TonnyChenProgramming/701/701_documentation/RecopDiagrams/taskSeperation.png

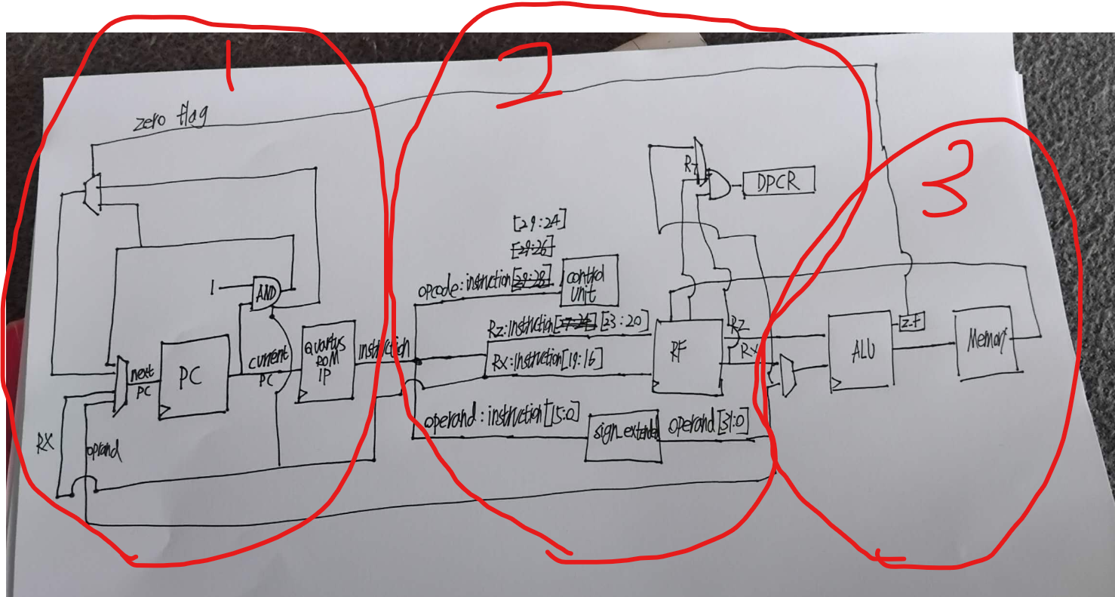
701_documentation/RecopDiagrams/taskSeperation.png
