TonnyChenProgramming/701/701_documentation/GP2_Member_B_Nios_Support_Plan.md

# GP2 Member B Nios II Support Plan

Owner: Eric / Member B

Branch: `Eric_GP2`

## Purpose

Member B owns the non-critical Nios II support path for GP2. After Zoran's MVP feedback, the minimum target is not to upload ReCOP instruction memory and not to force all Nios commands through ReCOP. The minimum target is to let a PC user send UART/JTAG UART configuration commands to Nios II, let Nios II package those commands as NoC packets for the relevant ASPs, and let Nios II display returned peak/frequency results from the NoC.

## Agreed System Flow

```text
PC UART command
    -> Nios II command parser
    -> Avalon-MM / NoC adapter registers
    -> ASP configuration packet over NoC
    -> ASP pipeline updates parameters
    -> Peak/result packet returns over NoC
    -> UART debug output and VGA result display
```

ReCOP remains useful, but its MVP role is the board-driven reactive controller: switches/buttons trigger START/STOP/CLEAR/status control packets to ASPs and LEDs show the result. Nios II is the UART/config/display processor.

Status is split by command owner. Nios II receives `CONFIG_DONE` and PK result/event packets because it owns UART configuration and display. ReCOP receives `START_DONE`, `STOP_DONE`, and `CLEAR_DONE` because it owns switches/buttons and the four ASP LEDs.

## Responsibility Split

| Member | Area | Main Responsibility |
| --- | --- | --- |
| A | ReCOP + board input controller | Read switches/buttons, send START/STOP/CLEAR/status packets to ASPs, drive LEDs/status response. |
| B | Nios II support subsystem | UART command parser, Nios-to-NoC register contract, ASP configuration packets, PK/result display path. |
| C | TDMA-MIN + ASP pipeline | NoC routing, ASP address map, ADC/AVG/COR/PK/output data movement, waveform evidence. |

Member B does not need to implement ASP algorithms or ReCOP internal instruction behavior. Member B only needs a clean support interface that can drive known ASP configuration packets and display returned status/results.

## GP2 Operating Modes

| Mode | Name | Intended Data Path |
| --- | --- | --- |
| `mode 1` | Correlation pipeline | `ADC -> AVG -> COR -> PK -> NoC -> Nios display` |
| `mode 2` | Direct pass-through | `ADC/source -> NoC/output`, bypassing `AVG/COR/PK` where possible |

The exact NoC route for mode 2 should be confirmed by Member C because it depends on how the TDMA-MIN ports are connected.

## Minimum Member B Deliverables

1. Nios II UART/JTAG UART command parser.
2. Packet helper definitions matching `common/asp_packet_pkg.vhd`.
3. Avalon-MM register contract for the Nios-to-NoC adapter.
4. Dry-run command output showing the 32-bit packet words Nios would send.
5. Evidence checklist for hardware/simulation testing.

The current implementation can run in dry-run mode before the hardware adapter is finished. When Platform Designer provides the adapter base address, the same console can be built with `NIOS_NOC_ADAPTER_BASE` so the command helpers write the adapter registers.

## UART Command Set

| Command | Meaning | Initial Nios Action |
| --- | --- | --- |
| `adc <dest> <ch> <div>` | Set ADC output destination, virtual channel, and sample divider. | Build and send/print ADC config packet. |
| `avg <dest> <win>` | Set AVG output destination and window `1,2,4,8,16`. | Build and send/print AVG config packet. |
| `corwin <n>` | Set correlation window `1..511`. | Build and send/print COR window config packet. |
| `offset <n>` | Set correlation offset | Build and send/print a COR config packet with offset value `n`. |
| `pk <dest> <sp> <th>` | Set PK output destination, min spacing, and threshold. | Build and send/print PK config packet. |
| `poll` | Read one returned packet from the hardware adapter | If `RX_VALID` is set, print decoded packet fields and acknowledge RX. |
| `rx <hex>` | Mock/decode one received packet | Dry-run display hook for PK/result packets before hardware RX exists. |
| `status` | Show current system status | Print cached ASP config, adapter status, and latest received packet/result. |

## Status / LED Rule

For MVP, status should not be broadcast everywhere. The target is:

```text
Nios CONFIG command -> ASP -> CONFIG_DONE status to Nios
ReCOP START command -> ASP -> START_DONE status to ReCOP -> LED on
ReCOP STOP command  -> ASP -> STOP_DONE status to ReCOP -> LED off
ReCOP CLEAR command -> ASP -> CLEAR_DONE status to ReCOP -> LED off
PK peak result      -> PK ASP -> EVENT packet to Nios
```

Nios caches the latest peak count, successful ASP config acknowledgements, and the most recent status response. UART can print this snapshot immediately. A later VGA layer should read the same snapshot instead of containing packet-decoding logic.

The lightweight `nios_display` module now formats this snapshot for UART and an optional Avalon character-buffer VGA. It deliberately avoids the larger C723 FreeRTOS graph task until the basic NoC result path works.

Suggested LED mapping:

| LED | ASP |
| --- | --- |
| `LED0` | ADC |
| `LED1` | AVG |
| `LED2` | COR |
| `LED3` | PK |

## Packet Format

The shared packet format is defined in `common/asp_packet_pkg.vhd`:

```text
[31:28] kind
[27:24] code
[23:20] dest
[19:0]  payload
```

Current shared node map:

| Node | Address |
| --- | --- |
| ReCOP/control source | `0x0` |
| ADC ASP | `0x1` |
| AVG ASP | `0x2` |
| Correlation ASP | `0x3` |
| Peak ASP | `0x4` |
| Nios II bridge | `0x5` |
| Idle/debug sink | `0x6` |
| Null/drop sink | `0x7` |

For Nios configuration commands, `dest` should be the target ASP address. ReCOP address `0x0` is mainly for ReCOP-originated board-control/status behavior, not the default Nios MVP path.

## Proposed Nios-to-ASP Command Packets

These packet words follow the shared packet layout and the current ASP decoder payload formats.

| UART Command | Packet Meaning | Example Word |
| --- | --- | --- |
| `adc avg 0 0` | `CMD_CONFIG` to ADC, output to AVG, channel `0`, divider `0` | `0x11120000` |
| `avg cor 4` | `CMD_CONFIG` to AVG, output to COR, window `4` | `0x11230200` |
| `corwin 64` | `CMD_CONFIG` to COR, `TAG_WINDOW`, value `64` | `0x11300040` |
| `offset 100` | `CMD_CONFIG` to COR, `TAG_OFFSET`, value `100` | `0x11310064` |
| `pk nios 200 0` | `CMD_CONFIG` to PK, output to Nios, spacing `200`, threshold `0` | `0x1145C800` |

Current tagged config fields:

| Tag | Meaning |
| --- | --- |
| `0x0` | Existing `TAG_WINDOW`, used by COR. |
| `0x1` | Existing `TAG_OFFSET`, used by COR. |

ADC, AVG, and PK currently use compact payload bitfields instead of tag/value payloads. See `ASP_NoC_Command_Interface.md` for the detailed layouts.

## Instruction Memory Upload Note

Instruction-memory upload is optional/stretch for GP2. The current ReCOP program memory is ROM/MIF based, so run-time upload would require a larger hardware change: writable program memory, an Avalon loader interface, reset/start control, and evidence that ReCOP fetches uploaded instructions.

For the minimum GP2 path, Nios II should not block on instruction-memory upload. The practical Member B path is:

```text
Nios II UART command -> NoC adapter -> ASP configuration packet
```

Instruction-memory upload can be revisited only if the team finishes the UART/config/status path early.

## Teammate Update Message

```text
I am working on Member B on branch Eric_GP2. After Zoran's MVP feedback, Nios II is mainly for UART configuration and UART/VGA display. It should not need ReCOP instruction-memory upload, and PK should not connect directly to Nios. My MVP flow is PC UART command -> Nios II -> NoC config packet -> target ASP, and PK/result packet -> NoC -> Nios II -> UART/VGA display. ReCOP stays useful as the board-driven reactive controller for START/STOP/CLEAR/status using switches/buttons/LEDs.
```

## Open Team Decisions

1. Confirm ADC/AVG TDMA wrappers from `origin/solomon-tdma-only` are merged into the team baseline.
2. Confirm whether ReCOP switch mode control changes ADC/AVG/COR routing or only START/STOP/CLEAR state.
3. Connect the exported adapter `noc_send` and `noc_recv` conduits to TDMA-MIN in Member C's integration top level. The Platform Designer adapter is mapped at `0x08011000`.
4. Confirm PK/result packet format for Nios display.

## Current Member B Progress

Completed:

1. Nios UART/JTAG UART command parser and compact console output.
2. Shared packet helpers and Avalon-NoC adapter register contract.
3. ModelSim adapter testbench with TX/RX handshake and loopback coverage.
4. Platform Designer adapter integration at `0x08011000`.
5. Physical-board adapter-local loopback smoke test.
6. Optional text-only VGA character-buffer build path at `0x08012000`.
7. Quartus full compilation and FPGA programming with the VGA build path.

Remaining:

1. Member C connects `noc_send` and `noc_recv` to the TDMA-MIN top level.
2. Run the real NoC test with `hwloop 0`.
3. Capture a VGA monitor photo later when a cable is available.
