TonnyChenProgramming/701/701_documentation/GP1_ReCOP_Design_Report.docx

COMPSYS 701 – Group Project 1
ReCOP Processor Implementation
Design Report

Group 6
Eric Chen (eche101) Tonny Chen (tche867) Xueyuan Ye (xye006)

# 1. Introduction

This report documents the design and implementation of a fully operational ReCOP (Reactive and Concurrency Processor) core completed for Group Project 1. ReCOP is a 16-bit RISC processor originally specified as a high-level programming model in the COMPSYS 701 materials. Our task was to expand that specification into a complete, synthesisable RTL design, build a supporting assembler toolchain, and demonstrate the processor executing user programs on an Intel/Altera FPGA.

The deliverables described in this report are: (i) a multi-cycle ReCOP datapath and control unit written in VHDL, (ii) a two-pass Python assembler that emits an Altera Memory Initialisation File (.mif) for the Program Memory, (iii) a QuestaSim testbench and regression program exercising all implemented instructions, and (iv) a synthesised design targeting the Terasic DE1-SoC development board, which hosts an Intel Cyclone V FPGA. The remainder of the report explains the system architecture, describes each major block, lists the customisations we made relative to the reference specification, and outlines how the design will extend into GP2.

# 2. System Architecture

## 2.1. ReCOP ISA

ReCOP follows a Harvard architecture with a separate Program Memory (PM) and Data Memory (DM). Each instruction is 32 bits wide and has the following fixed format:

[AM:2] [Opcode:6] [Rz:4] [Rx:4] [Operand:16]

## 2.2. ReCOP Datapath

The datapath is organised into five logical blocks to meet the ISA requirement.

- Block 1 – Fetch: Program Counter and Instruction Memory Quartus ROM IP
- Block 2 – Decode and Control: Register file and control unit
- Block 3 – Execute: Arithmetic logic unit and External Register port in
- Block 4 – Memory: Data Memory Quartus RAM IP
- Block 5 – WriteBack: the same register file

In the fetch stage, the next program counter (PC) value is generated by the program counter module and provided to the instruction memory (ROM IP) to retrieve the next instruction. Both the PC update and the instruction memory access require one clock cycle.

During the decode stage, the instruction is interpreted by the control unit, which generates the necessary control signals for the subsequent stages. At the same time, the register file is accessed to read the required operand values based on the instruction fields.

In the following stage, the data path is directed according to the control signals. If an arithmetic or external port interaction is required, the operands are sent to the execute block. Alternatively, for memory-related instructions, the operation is handled by the memory block to perform data read or write.

Finally, in the write-back stage, the result is written back to the register file when required by the instruction.

## 2.3. ReCOP Control Path: A Moore's Machine Implementation

The Control Unit is a Moore-style finite state machine with six top-level states – Fetch (S_FETCH), Decode (S_DECODE), Execute (S_EXECUTE), Memory Read (S_MEMREAD), Memory Write (S_MEMWRITE), and Writeback (S_WRITEBACK) – that loop indefinitely.

Each state has a duration equal to one system clock period of 20 ns (50 MHz), as determined through timing analysis in Quartus.

During clock cycle 1, S_FETCH retrieves the instruction from program memory based on the current PC value. In clock cycle 2, S_DECODE interprets the instruction using combinational logic to determine the next state and reads the required operands from the register file. In clock cycle 3, the system transitions to S_EXECUTE, S_MEMREAD, or S_MEMWRITE depending on the decoded instruction. In clock cycle 4, the system either returns to S_FETCH or enters S_WRITEBACK to write the computed result back to the register file.

## 2.4. System-Level Context

The ReCOP delivered by GP1 will be integrated into a Heterogeneous Multi-Processor System-on-Chip (HMPSoC) during GP2. The critical subsystem comprises three Application-Specific Processors (ADC-ASP, Processing-ASP, and DAC-ASP) interconnected by the TDMA-MIN Network-on-Chip. ReCOP acts as the reactive controller: it receives user commands from on-board peripherals and issues configuration commands over the NoC to the ASP pipeline. A Nios II processor joins the same NoC to provide debugging and reconfiguration services.

## 2.5. ReCOP Top-Level Interface

The top-level entity exposes the following external interface to DE1-SoC peripherals:

Signal | Direction | Width | Purpose
CLOCK_50 | in | 1 | System clock (50 MHz)
KEY[3:0] | in | 4 | Reset and soft buttons (active-low)
SW[17:0] | in | 16 | Configuration inputs / SIP source (lower 16 bits)
LEDR[17:0] | out | 16 | Status output / SOP display (lower 16 bits)
HEX0..HEX7 | out | 7 each | Seven-segment digits (SVOP and PC for debug)
DPCR_out | out | 32 | Data-processing call register to NoC (GP2)

## 2.6. Memory Organisation

Program Memory is implemented as a 512 × 32-bit ROM using an Altera altsyncram megafunction in single-port ROM mode, initialised with program.mif. Data Memory is a 512 × 32-bit synchronous RAM from the same megafunction in SINGLE_PORT mode. Both memories target the Cyclone IV E device family and occupy two M9K block-RAM resources each.

The DM is 32 bits wide rather than 16 bits to keep PM and DM architecturally uniform and to leave headroom for GP2, where 32-bit data structures such as DPCR snapshots can be stored without a second memory pass. For the 16-bit LDR and STR accesses in GP1, the upper 16 bits of the DM word are zero-extended on writes and discarded on reads.

Both memories use 9-bit addresses, so the PC uses only its lower 9 bits. This keeps BRAM usage compact for GP1 while preserving the full 16-bit address space for GP2.

# 3. Block-Level Design

## 3.1. S_FETCH (T1)

The Fetch block contains a 16-bit Program Counter and the 32-bit Instruction Register. Pre-fetching is used: the PC value is updated in the previous clock cycle (in parallel with T3), so the Fetch stage only consumes one cycle for the instruction memory read.

## 3.2. S_DECODE (T2)

Decode extracts the following fields from IR at T2:

AM = IR[31:30] opcode = IR[29:24] sel_z = IR[23:20] sel_x = IR[19:16] operand = IR[15:0]

Based on the decoded opcode, the control unit determines the next execution path and generates control signals for S_EXECUTE, S_MEMREAD, or S_MEMWRITE. The register file is accessed concurrently so that operand values are available for the next stage.

## 3.3. S_EXECUTE (T3)

The ALU performs the required computation based on the decoded opcode and operands from the register file or the immediate field. S_EXECUTE also handles external port I/O (SIP read, SOP write), special register access (DPCR write, DPRR read), and control-flow resolution (PC ← target for jumps, or PC ← PC + 1 otherwise).

## 3.4. S_MEMREAD (T3)

Data memory is configured in read mode. The retrieved data is forwarded to the register file for the subsequent S_WRITEBACK stage. The PC is updated to PC + 1 in parallel.

## 3.5. S_MEMWRITE (T3)

Data memory is configured in write mode. The data from the selected source (Rx, operand, or PC) is written to the effective address. The PC is updated to PC + 1 in parallel.

## 3.6. S_WRITEBACK (T4)

Entered only for instructions that require a register write-back. The register file write-enable is asserted and the appropriate data source is selected and written to the target register, completing the instruction execution cycle.

## 3.7. Control-Unit State Summary

State | Active Signals | Datapath Action
T1 (S_FETCH) | pc_write=1; pc_sel=pc_sel_zero (init only) | IR ← PM[PC]; PC prepared from previous cycle (prefetch)
T2 (S_DECODE) | rf_read (implicit) | Decode IR; read Rx, Rz; operand prepared for next stage
T3 (S_EXECUTE) | alu_operation, alu_op1_sel, alu_op2_sel, pc_write, pc_sel, dpcr_wr, sop_wr | Rz ← ALU(…); port I/O; DPCR/DPRR; PC ← target or PC+1
T3 (S_MEMREAD) | dm_read_enable, dm_addr_sel, pc_write, pc_sel=PC+1 | data ← DM[address]; forwarded to writeback stage
T3 (S_MEMWRITE) | dm_write_enable, dm_addr_sel, dm_data_sel, pc_write, pc_sel=PC+1 | DM[address] ← data (from Rx, operand, or PC)
T4 (S_WRITEBACK) | ld_r, rf_input_sel | Rz ← ALU result / DM data / immediate / SIP

# 4. Assembler

recop_asm.py is a two-pass Python assembler that translates ReCOP assembly source files (.asm) into Altera Memory Initialisation Files (.mif) for loading into the Program Memory ROM at synthesis time. It also produces a human-readable listing file (.lst) for verification. The assembler is implemented in approximately 570 lines of Python with no external dependencies beyond the standard library.

## 4.1. Instruction Encoding

Every ReCOP instruction is a fixed-width 32-bit word. The field layout matches opcodes.vhd and control_signal_generator.vhd in the hardware:

31 30 29 24 23 20 19 16 15 0
┌─────────┬──────────┬─────────┬─────────┬────────────────┐
│ AM │ OPCODE │ Rz │ Rx │ OPERAND │
│ 2 bits │ 6 bits │ 4 bits │ 4 bits │ 16 bits │
└─────────┴──────────┴─────────┴─────────┴────────────────┘

Field | Bits | Description
AM | 31–30 | Addressing mode
OP | 29–24 | 6-bit opcode
Rz | 23–20 | Destination or primary source register (R0–R15)
Rx | 19–16 | Secondary source register (R0–R15)
OPERAND | 15–0 | 16-bit immediate value or direct memory address

Note: This is the v2 encoding where AM occupies the two most-significant bits. The earlier v1 encoding placed AM in the low bits of the upper byte. The v2 layout lets the control unit extract AM without masking the opcode field, and it is the encoding agreed across all team members' hardware.

## 4.2. Addressing Modes

AM Code | Name | Syntax Prefix | Meaning
00 | Inherent | (none) | No explicit operand — uses implicit values or flags
01 | Immediate | # | OPERAND field holds a literal 16-bit value
10 | Direct | $ | OPERAND field holds a 16-bit memory address
11 | Register | Rn | Operand comes from register Rx; OPERAND unused

## 4.3. Full Opcode Table

Mnemonic | OP (binary) | Default AM | Syntax | Operation
LDR | 000000 | IMM/DIR/REG | LDR Rz #imm / LDR Rz $addr / LDR Rz Rx | Rz ← imm / DM[addr] / Rx
STR | 000010 | DIR/REG/IMM | STR Rx $addr / STR Rz Rx / STR Rz #imm | DM[addr]←Rx / Rz←Rx / Rz←imm
SUBV | 000011 | IMM/REG | SUBV Rz Rx #imm / SUBV Rz Rx | Rz ← Rx − imm / Rz − Rx
SUB | 000100 | IMM | SUB Rz #imm | Rz ← Rz − imm; sets Z flag
AND | 001000 | IMM/REG | AND Rz Rx #imm / AND Rz Rx | Rz ← Rx AND imm / Rz AND Rx
OR | 001100 | IMM/REG | OR Rz Rx #imm / OR Rz Rx | Rz ← Rx OR imm / Rz OR Rx
CLFZ | 010000 | INH | CLFZ | Clear Z flag
SZ | 010100 | IMM | SZ label | Branch to label if Z = 1
JMP | 011000 | IMM/REG | JMP label / JMP Rx | PC ← label / PC ← Rx
PRESENT | 011100 | IMM | PRESENT Rz label | Branch; Rz ← return address
STRPC | 011101 | DIR | STRPC $addr | DM[addr] ← PC
MAX | 011110 | IMM | MAX Rz #imm | Rz ← max(Rz, imm)
ADD | 111000 | IMM/REG | ADD Rz Rx #imm / ADD Rz Rx | Rz ← Rx + imm / Rz + Rx
DATACALL | 101000 | REG | DATACALL Rx | DPCR ← {R7, Rx}; assert IRQ
DATACALL | 101001 | IMM | DATACALL Rx #val | DPCR ← {Rx, val}; assert IRQ
SRES | 101010 | REG | SRES Rz | Rz ← DPRR result register
NOOP | 110100 | INH | NOOP | No operation
LER | 110110 | DIR | LER Rz | Rz ← ER (End-Ready register)
LSIP | 110111 | DIR | LSIP Rz | Rz ← SIP (Serial Input Port)
SSOP | 111010 | DIR | SSOP Rx | SOP ← Rx
SSVOP | 111011 | DIR | SSVOP Rx | SVOP ← Rx
CER | 111100 | INH | CER | Clear ER flag
CEOT | 111110 | INH | CEOT | Clear EOT flag
SEOT | 111111 | INH | SEOT | Set EOT flag

Note: R0 is hardwired to zero in the register file — writes to R0 are discarded.

## 4.4. Source File Syntax

Each source line follows the pattern:

[label[:]] MNEMONIC [operands] [; comment]

Token | Format | Examples
Register | R0–R15 (case-insensitive) | R0, r15, R7
Immediate | #<value> | #10, #0xFF, #0b1010, #0o17
Direct address | $<value> | $0, $0x1FF
Label reference | bare name or #name | LOOP, #LOOP

Directives:

Directive | Syntax | Effect
.ORG | .ORG <addr> | Set the current program counter to addr
.EQU | .EQU <NAME> <value> | Define a named constant (substituted at pass 2)
.WORD | .WORD <value> | Insert a raw 32-bit word at the current PC
ENDPROG / END | — | Stop assembling; remaining lines are ignored

## 4.5. Two-Pass Operation

### Pass 1 — Symbol Collection

The assembler scans every source line, tracking the program counter. Any token that is not a recognised mnemonic or directive is treated as a label and stored in the symbol table with its current PC value. .ORG updates the PC; .EQU populates the equates table; .WORD and instruction lines each advance the PC by one. No code is emitted in pass 1.

### Pass 2 — Code Generation

Each instruction line is encoded into a 32-bit word using the pack() function. Label references and .EQU names are resolved against the tables built in pass 1. Numeric literals accept decimal, 0x hex, 0b binary, and 0o octal. Because all symbol addresses are known before pass 2 begins, forward references are resolved correctly.

The pack() function assembles fields as follows:

word = (am & 0x03) << 30
| (op & 0x3F) << 24
| (rz & 0x0F) << 20
| (rx & 0x0F) << 16
| (operand & 0xFFFF)

## 4.6. Output Files

### MIF File

The Altera Memory Initialisation File is loaded into the altsyncram ROM at synthesis. It declares DEPTH = 512, WIDTH = 32, ADDRESS_RADIX = HEX, and DATA_RADIX = HEX. Every address from 0x000 to 0x1FF is written explicitly; locations containing no instruction are filled with 0x34000000 (the NOOP encoding).

### Listing File

The listing file decodes every assembled instruction into human-readable columns showing the address, 32-bit hex word, addressing mode, opcode mnemonic, Rz, Rx, operand value, and the original source line. It also prints the symbol table and any .EQU equates at the top, making it straightforward to verify program behaviour against expected register and memory state.

ADDR HEX AM OPCODE Rz Rx OPERAND SOURCE
0x0000 47800005 IMM ADD R7 R0 5 ADD R7 R0 #5
0x0001 8C070000 DIR LDR R0 R0 0 LSIP R0

## 4.7. Command-Line Usage

python recop_asm.py source.asm # outputs source.mif and source.lst
python recop_asm.py source.asm -o prog.mif # custom MIF path
python recop_asm.py source.asm -l prog.lst # custom listing path
python recop_asm.py source.asm --depth 256 # non-default PM depth

Copy the output .mif into the Quartus project directory (renaming it to match the filename referenced in instruction_memory_ip.vhd) before running synthesis.

## 4.8. Test Programs

File | Description
example2.asm | Exercises all 24 implemented instructions at least once
alu_basic_test.asm | Focused ALU test: ADD, SUB, SUBV, AND, OR, MAX
full_test.asm | Comprehensive regression: arithmetic, branches, memory, I/O
exmaple_full_test.asm | Extended system-level test including DATACALL and SIP/SOP
test_program.asm | General-purpose test program
pm_test.mif | Pre-assembled MIF for example2.asm — use directly without re-assembling
*.lst | Assembler listing files for each .asm — inspect expected register/memory state

# 5. Additions and Customisations

The baseline ReCOP specification describes a programming model and ISA but leaves many implementation choices open. This section enumerates the concrete design decisions and additions our implementation makes relative to the original specification.

## 5.1. Instruction Format – [AM:2][OP:6] Ordering

The 32-bit instruction places the addressing mode in bits 31–30 and the opcode in bits 29–24. Placing AM at the top of the word makes it straightforward to route AM directly to the Control Unit's output-function MUX without first masking the opcode field. Both the assembler encoder and the hardware decoder agree on this layout, which is important because several instructions (AND, OR, ADD, LDR, STR, DATACALL) share an opcode and are disambiguated only by AM.

## 5.2. Split DATACALL Opcodes

The reference ISA documents a single DATACALL mnemonic with two behaviours: the register form (DPCR ← {R7, Rx}) and the immediate form (DPCR ← {Rx, Operand}). To keep the Control Unit's DPCR-source MUX selection trivially decodable from a single opcode bit, two distinct 6-bit opcodes were allocated: 101000 for the register form and 101001 for the immediate form. The assembler emits the correct opcode automatically based on the number and type of arguments supplied, so this split is invisible to the programmer.

## 5.3. I/O Register Customisation

SIP, SOP, and SVOP are mapped to DE1-SoC on-board peripherals: SIP is driven from SW[15:0]; SOP is routed to LEDR[15:0]; SVOP drives HEX0–HEX3 through a hex-to-segment decoder. HEX4–HEX7 display the lower byte of the PC and the current CU state to support live debugging of program flow.

## 5.4. Reset Behaviour

Reset is active-high internally but driven externally by KEY[0], which is active-low on DE1-SoC; an inverter at the top level reconciles the polarities. On reset the PC is cleared, all general-purpose registers are cleared, the Z flag is cleared, and the DPCR is set to zero. IR is not reset explicitly because T1 overwrites it unconditionally before it is ever consumed.

# 6. Simulation and Testing

Verification is performed in QuestaSim using a VHDL testbench that instantiates the top-level ReCOP and preloads PM with a regression program (example2.asm / pm_test.mif) that exercises every implemented instruction at least once. The testbench drives CLOCK_50 at 20 ns and holds reset high for two cycles, then releases it and runs for several hundred nanoseconds.

Correctness is checked both visually (waveform inspection of the Register File, ALU result, DM bus, and DPCR) and by the written .lst listing from the assembler, which documents the expected behaviour for each instruction. Post-route timing was checked in Quartus; the multi-cycle organisation means the critical path (ALU + register-file write-back) runs comfortably within the 50 MHz clock period with slack to spare.

# 7. Extensions Planned for GP2

From a system-level RTL perspective, the DPRR register will be extended from two bits to three bits, with each bit corresponding to an individual ASP unit, enabling scalable interaction with multiple ASPs. Network interface modules will be implemented at both the transmit (NI TX) and receive (NI RX) ends to support communication over the TDMA-MIN multistage interconnect network.

From a system integration perspective, a programming interface will be introduced between the ReCOP program memory and the Nios II softcore processor, allowing runtime updates of program contents via .mif files without requiring resynthesis.

To support better software implementation, two additional status bits – End of Task (EOT) and EReady (ER) – are introduced. These signals provide a lightweight synchronisation mechanism between the ReCOP core and the ASPs. When ReCOP issues a command to a target ASP, it clears the corresponding DPRR bit to 0, then monitors it until the ASP sets it to 1 to signal completion. ReCOP does not stall during this period, enabling concurrent task execution. Similarly, the EOT and ER bits allow the system to handle asynchronous events reactively, which is reflected in ReCOP's name: Reactive and Concurrent Processor.

# 8. Conclusion

The ReCOP core delivered for GP1 constitutes a complete multi-cycle 16-bit processor implementation, accompanied by a custom assembler and verification flow. All mandatory instructions in the reference ISA are fully supported. The architecture adopts a modular six-block partitioning consistent with the Fetch, Decode, Execute, Memory, and Writeback stages, while meeting the specified clock cycle requirements. Furthermore, the design provides a well-defined external interface, enabling seamless integration into the HMPSoC environment in GP2. The proposed GP2 extensions further strengthen its suitability for system-level deployment.
