TonnyChenProgramming/701/701_documentation/RecopDiagrams/RecopDocs.docx

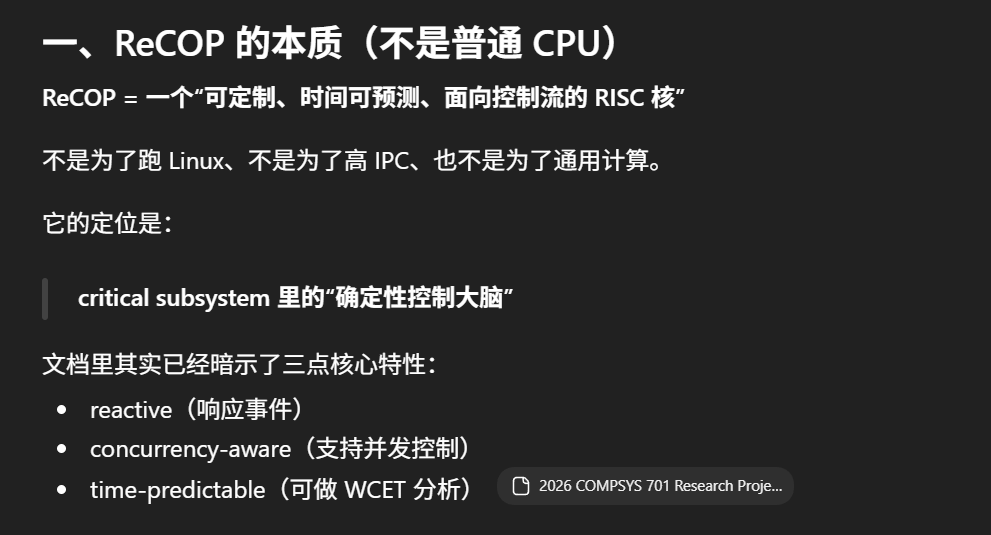
[picture p24: figure]
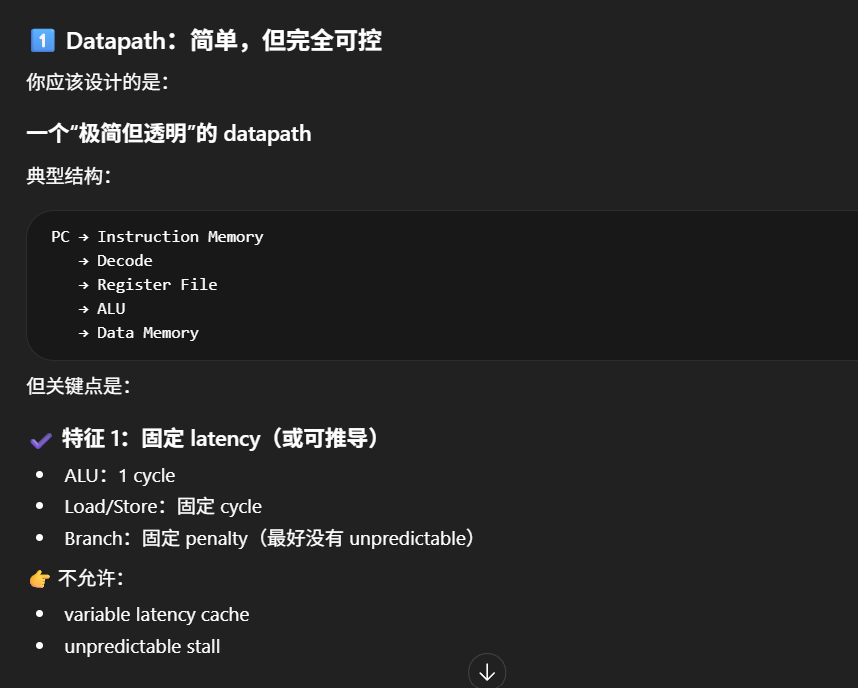
[picture p25: figure]
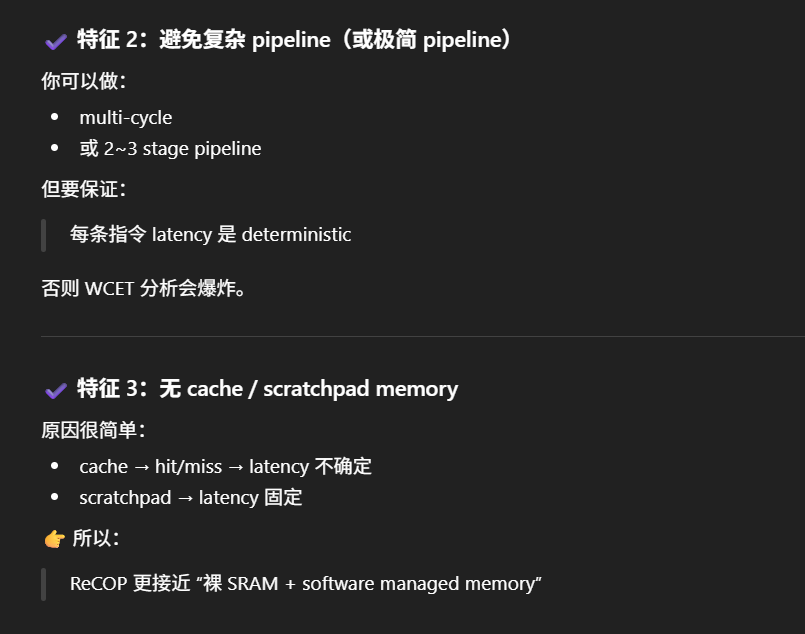
[picture p26: figure]
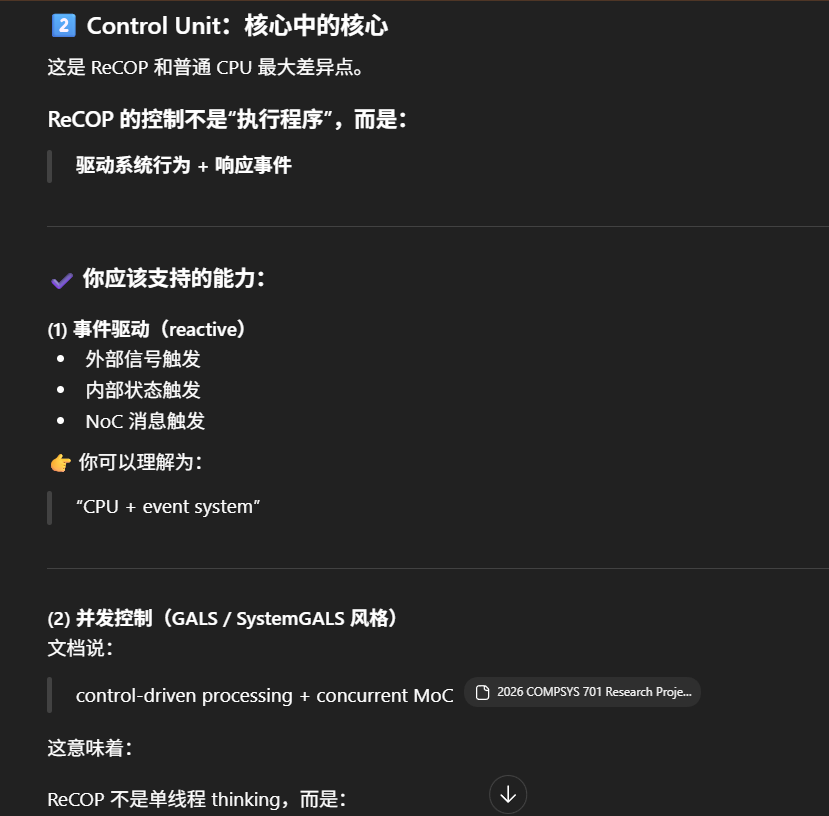
[picture p27: figure]
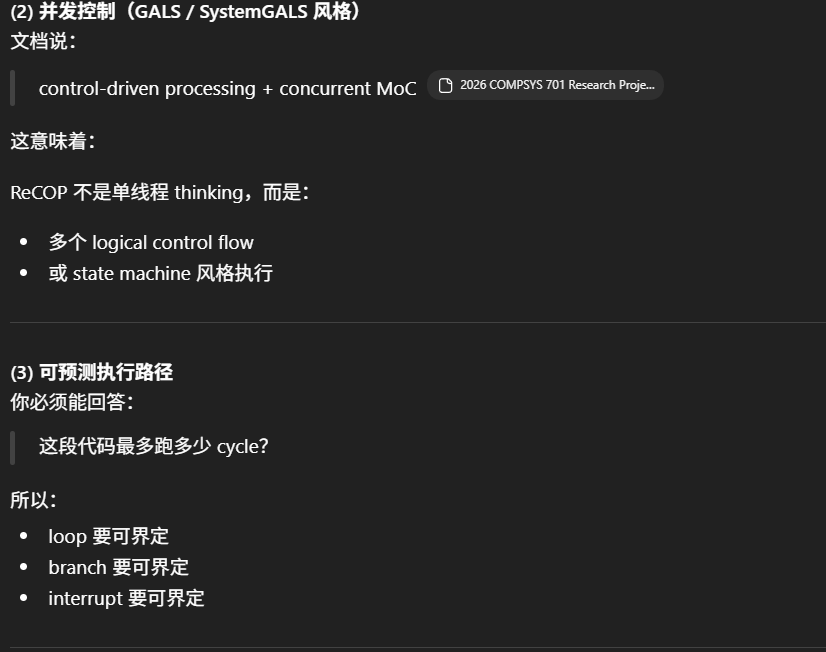
[picture p28: figure]
