TonnyChenProgramming/701/701_documentation/RecopDiagrams/datapath.png

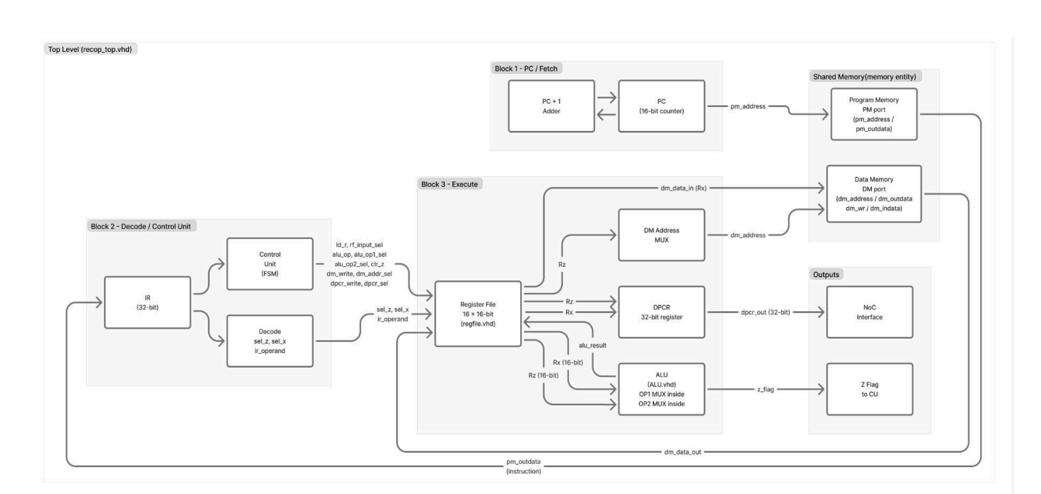
701_documentation/RecopDiagrams/datapath.png
