TonnyChenProgramming/701/701_documentation/RecopDiagrams/dpcall_software.png

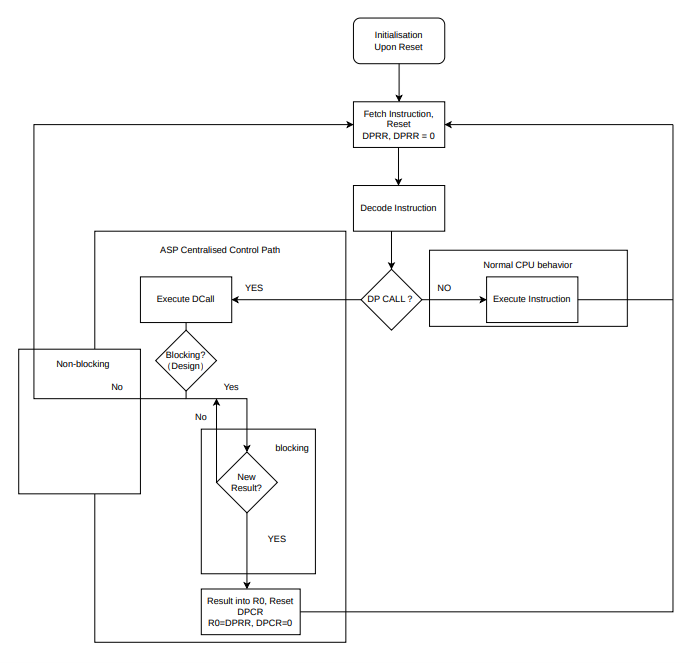
701_documentation/RecopDiagrams/dpcall_software.png
