TonnyChenProgramming/701/nios_support/adapter/avalon_noc _adapter_wave.bmp

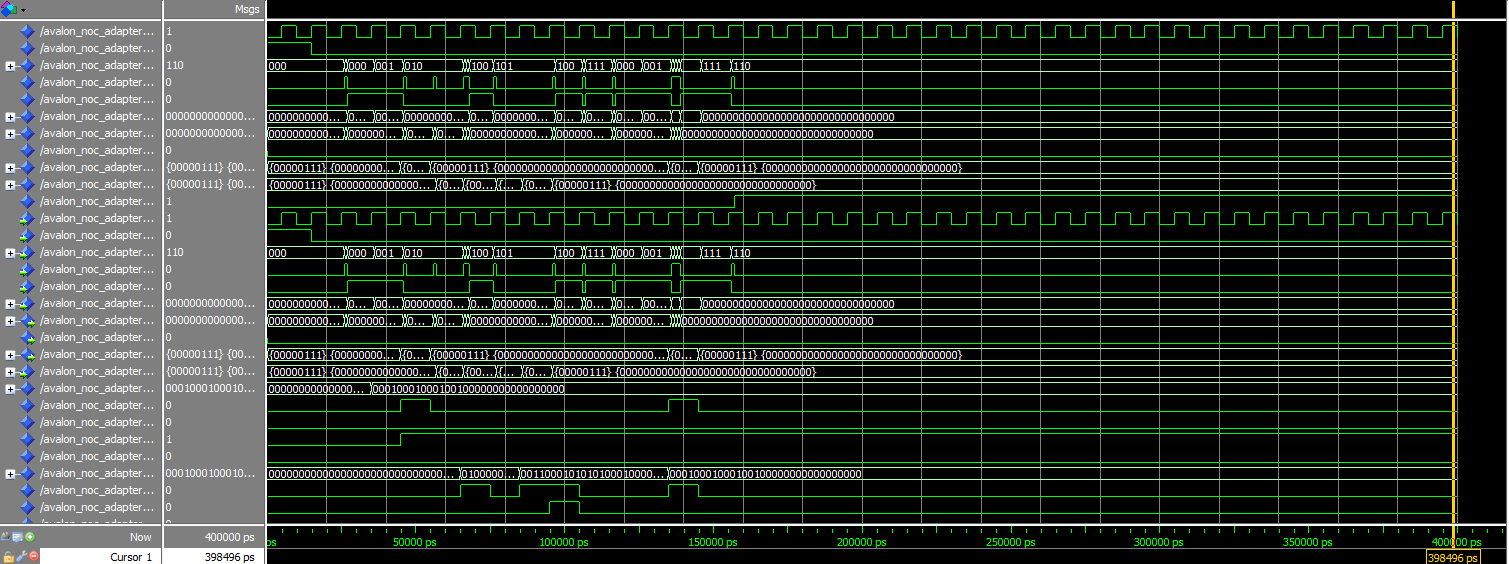
nios_support/adapter/avalon_noc _adapter_wave.bmp
