TonnyChenProgramming/701/PD-ASP/pd_asp_wave_overview.png

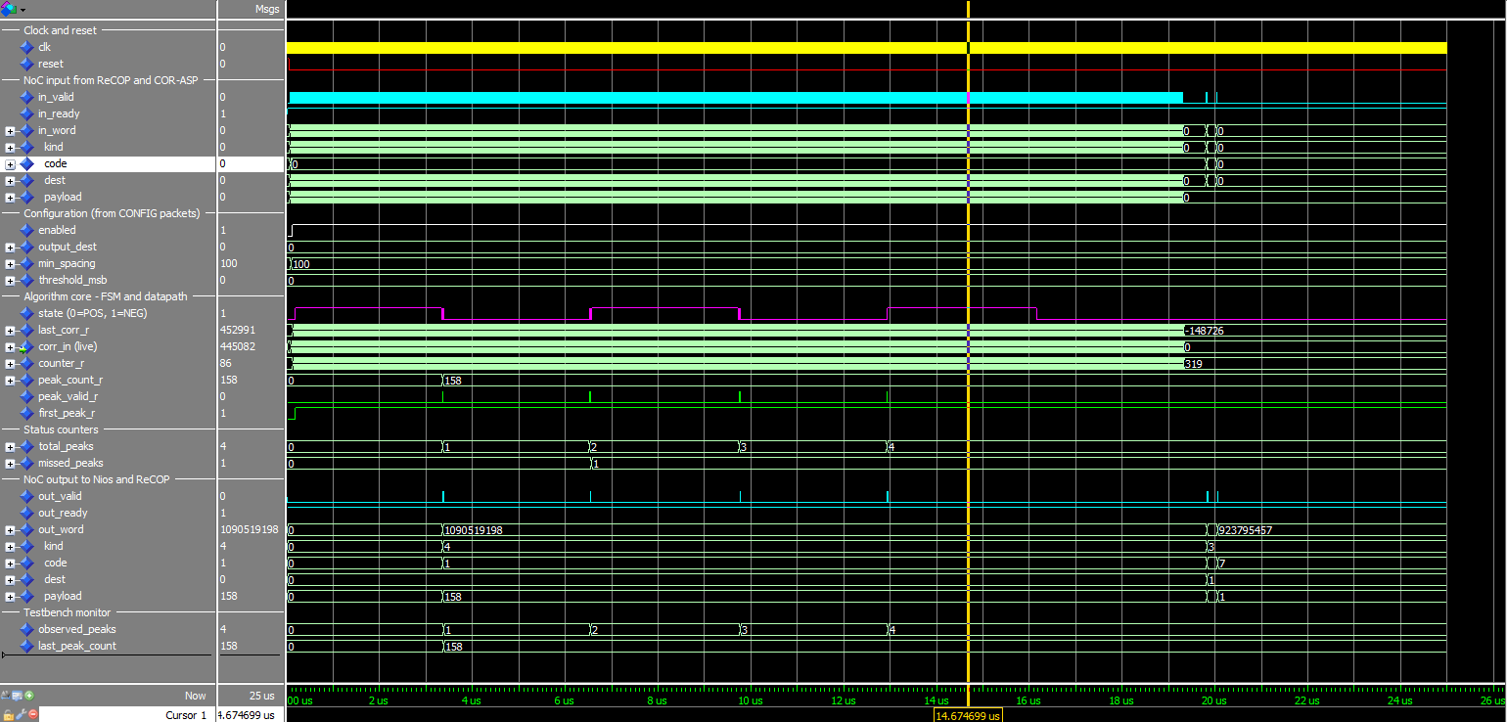
PD-ASP/pd_asp_wave_overview.png
