TonnyChenProgramming/701/PD-ASP/pd_asp_wave_peak_detail.png

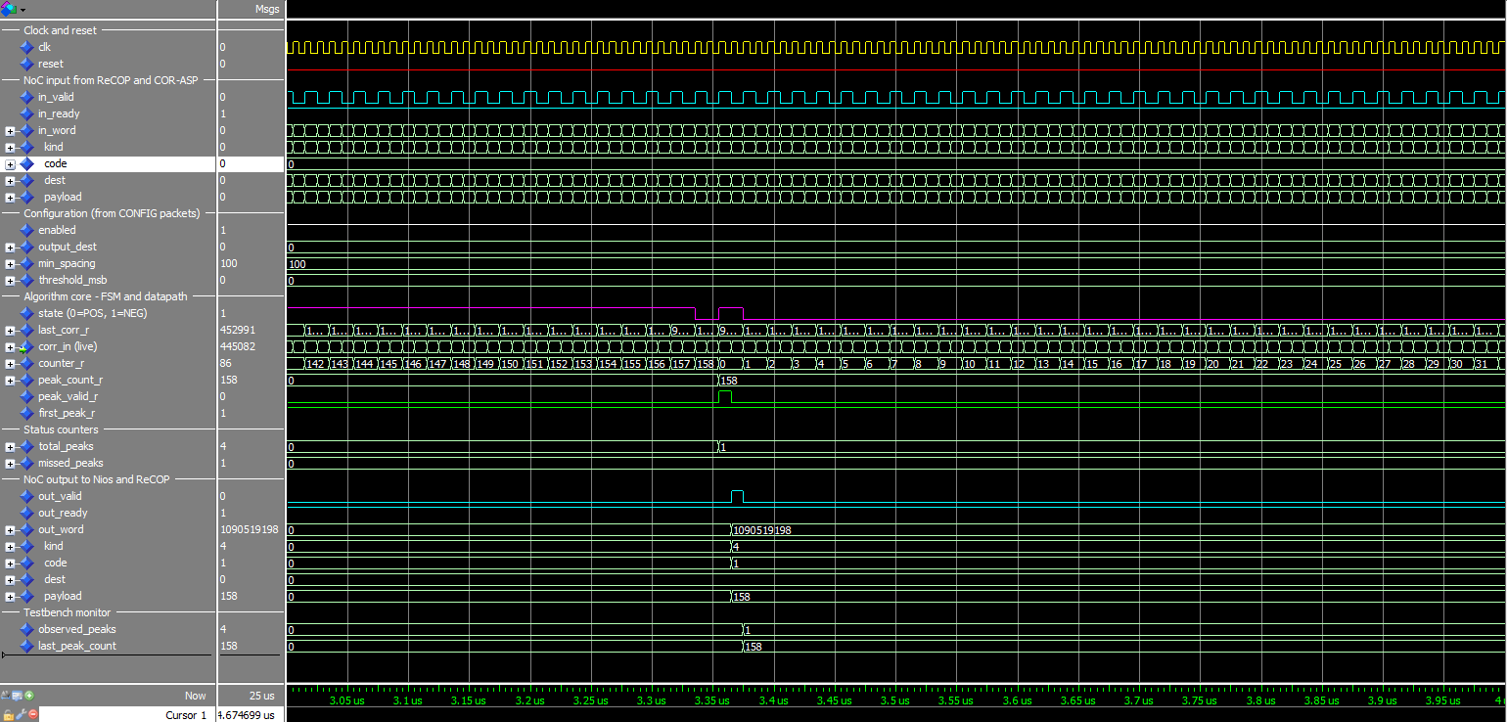
PD-ASP/pd_asp_wave_peak_detail.png
