TonnyChenProgramming/701/(list of files, cad)

Other CAD files:
701_documentation/RecopResource/RecopVHDL_old/work/alu/combined.psm
701_documentation/RecopResource/RecopVHDL_old/work/control_signal_generator/beh.psm
701_documentation/RecopResource/RecopVHDL_old/work/data_mem/syn.psm
701_documentation/RecopResource/RecopVHDL_old/work/data_memory_ip/syn.psm
701_documentation/RecopResource/RecopVHDL_old/work/decodeandwriteback/beh.psm
701_documentation/RecopResource/RecopVHDL_old/work/execute/beh.psm
701_documentation/RecopResource/RecopVHDL_old/work/fetch/beh.psm
701_documentation/RecopResource/RecopVHDL_old/work/instructin_memory_ip/syn.psm
701_documentation/RecopResource/RecopVHDL_old/work/instruction_memory_comb/beh.psm
701_documentation/RecopResource/RecopVHDL_old/work/instruction_memory_ip/syn.psm
701_documentation/RecopResource/RecopVHDL_old/work/memory/beh.psm
701_documentation/RecopResource/RecopVHDL_old/work/memory_arbiter/behaviour.psm
701_documentation/RecopResource/RecopVHDL_old/work/multicycle_moore_machine/beh.psm
701_documentation/RecopResource/RecopVHDL_old/work/opcodes/_vhdl.psm
701_documentation/RecopResource/RecopVHDL_old/work/pll/syn.psm
701_documentation/RecopResource/RecopVHDL_old/work/prog_mem/syn.psm
701_documentation/RecopResource/RecopVHDL_old/work/program_counter/beh.psm
701_documentation/RecopResource/RecopVHDL_old/work/recop_ip/structural.psm
701_documentation/RecopResource/RecopVHDL_old/work/recop_ip_tb/sim.psm
701_documentation/RecopResource/RecopVHDL_old/work/recop_pll/syn.psm
701_documentation/RecopResource/RecopVHDL_old/work/recop_top/beh.psm
701_documentation/RecopResource/RecopVHDL_old/work/recop_top_tb/sim.psm
701_documentation/RecopResource/RecopVHDL_old/work/recop_types/_vhdl.psm
701_documentation/RecopResource/RecopVHDL_old/work/regfile/beh.psm
701_documentation/RecopResource/RecopVHDL_old/work/registerfile/syn.psm
701_documentation/RecopResource/RecopVHDL_old/work/registers/beh.psm
701_documentation/RecopResource/RecopVHDL_old/work/sim_dm/beh.psm
701_documentation/RecopResource/RecopVHDL_old/work/various_constants/_vhdl.psm
PD-ASP/work/asp_packet_pkg/_vhdl.psm
PD-ASP/work/asp_packet_pkg/body.psm
PD-ASP/work/pd_asp/rtl.psm
PD-ASP/work/pd_asp_tb/sim.psm
PD-ASP/work/pd_core/rtl.psm
recop/RecopVHDL/Main/work/alu/combined.psm
recop/RecopVHDL/Main/work/data_memory_ip/syn.psm
recop/RecopVHDL/Main/work/execute/beh.psm
recop/RecopVHDL/Main/work/instruction_memory_ip/syn.psm
recop/RecopVHDL/Main/work/multicycle_moore_machine/beh.psm
recop/RecopVHDL/Main/work/opcodes/_vhdl.psm
recop/RecopVHDL/Main/work/program_counter/beh.psm
recop/RecopVHDL/Main/work/recop_de1_soc_test/beh.psm
recop/RecopVHDL/Main/work/recop_top/beh.psm
recop/RecopVHDL/Main/work/recop_top_tb/sim.psm
recop/RecopVHDL/Main/work/recop_top_v1/beh.psm
recop/RecopVHDL/Main/work/recop_types/_vhdl.psm
recop/RecopVHDL/Main/work/regfile/beh.psm
recop/RecopVHDL/Main/work/registers/beh.psm
recop/RecopVHDL/Main/work/various_constants/_vhdl.psm
