TonnyChenProgramming/701/701_documentation/HMPSOCDiagram/systemLevel701.pdf

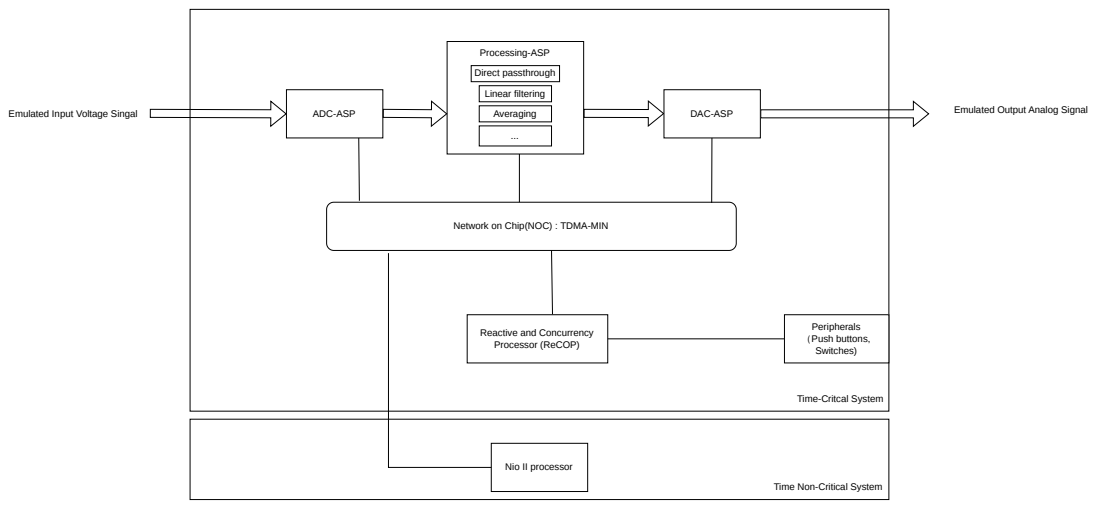
[picture p34: page 1]
Emulated Input Voltage Singal; ADC-ASP; Direct passthrough; Processing-ASP; Linear filtering; Averaging; Peripherals （Push buttons, Switches)

Emulated Output Analog Signal DAC-ASP

Network on Chip(NOC) : TDMA-MIN

Reactive and Concurrency
Processor (ReCOP)

Time-Critcal System

Nio II processor

Time Non-Critical System
