TonnyChenProgramming/701/nios_support/quartus/software/nios_adapter_console_bsp/system.h

/*
 * system.h - SOPC Builder system and BSP software package information
 *
 * Machine generated for CPU 'cpu' in SOPC Builder design 'Nios_System_2A'
 * SOPC Builder design path: ../../Nios_System_2A.sopcinfo
 *
 * Generated: Sun Jun 07 12:57:54 NZST 2026
 */

/*
 * DO NOT MODIFY THIS FILE
 *
 * Changing this file will have subtle consequences
 * which will almost certainly lead to a nonfunctioning
 * system. If you do modify this file, be aware that your
 * changes will be overwritten and lost when this file
 * is generated again.
 *
 * DO NOT MODIFY THIS FILE
 */

/*
 * License Agreement
 *
 * Copyright (c) 2008
 * Altera Corporation, San Jose, California, USA.
 * All rights reserved.
 *
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
 * This agreement shall be governed in all respects by the laws of the State
 * of California and by the laws of the United States of America.
 */

#ifndef __SYSTEM_H_
#define __SYSTEM_H_

/* Include definitions from linker script generator */
#include "linker.h"


/*
 * BUTTON_pio configuration
 *
 */

#define ALT_MODULE_CLASS_BUTTON_pio altera_avalon_pio
#define BUTTON_PIO_BASE 0x8011040
#define BUTTON_PIO_BIT_CLEARING_EDGE_REGISTER 0
#define BUTTON_PIO_BIT_MODIFYING_OUTPUT_REGISTER 0
#define BUTTON_PIO_CAPTURE 1
#define BUTTON_PIO_DATA_WIDTH 2
#define BUTTON_PIO_DO_TEST_BENCH_WIRING 0
#define BUTTON_PIO_DRIVEN_SIM_VALUE 0
#define BUTTON_PIO_EDGE_TYPE "RISING"
#define BUTTON_PIO_FREQ 50000000
#define BUTTON_PIO_HAS_IN 1
#define BUTTON_PIO_HAS_OUT 0
#define BUTTON_PIO_HAS_TRI 0
#define BUTTON_PIO_IRQ 2
#define BUTTON_PIO_IRQ_INTERRUPT_CONTROLLER_ID 0
#define BUTTON_PIO_IRQ_TYPE "EDGE"
#define BUTTON_PIO_NAME "/dev/BUTTON_pio"
#define BUTTON_PIO_RESET_VALUE 0
#define BUTTON_PIO_SPAN 16
#define BUTTON_PIO_TYPE "altera_avalon_pio"


/*
 * CPU configuration
 *
 */

#define ALT_CPU_ARCHITECTURE "altera_nios2_gen2"
#define ALT_CPU_BIG_ENDIAN 0
#define ALT_CPU_BREAK_ADDR 0x08010820
#define ALT_CPU_CPU_ARCH_NIOS2_R1
#define ALT_CPU_CPU_FREQ 50000000u
#define ALT_CPU_CPU_ID_SIZE 1
#define ALT_CPU_CPU_ID_VALUE 0x00000001
#define ALT_CPU_CPU_IMPLEMENTATION "fast"
#define ALT_CPU_DATA_ADDR_WIDTH 0x1c
#define ALT_CPU_DCACHE_LINE_SIZE 0
#define ALT_CPU_DCACHE_LINE_SIZE_LOG2 0
#define ALT_CPU_DCACHE_SIZE 0
#define ALT_CPU_EXCEPTION_ADDR 0x04000020
#define ALT_CPU_FLASH_ACCELERATOR_LINES 0
#define ALT_CPU_FLASH_ACCELERATOR_LINE_SIZE 0
#define ALT_CPU_FLUSHDA_SUPPORTED
#define ALT_CPU_FREQ 50000000
#define ALT_CPU_HARDWARE_DIVIDE_PRESENT 0
#define ALT_CPU_HARDWARE_MULTIPLY_PRESENT 1
#define ALT_CPU_HARDWARE_MULX_PRESENT 0
#define ALT_CPU_HAS_DEBUG_CORE 1
#define ALT_CPU_HAS_DEBUG_STUB
#define ALT_CPU_HAS_EXTRA_EXCEPTION_INFO
#define ALT_CPU_HAS_ILLEGAL_INSTRUCTION_EXCEPTION
#define ALT_CPU_HAS_JMPI_INSTRUCTION
#define ALT_CPU_ICACHE_LINE_SIZE 0
#define ALT_CPU_ICACHE_LINE_SIZE_LOG2 0
#define ALT_CPU_ICACHE_SIZE 0
#define ALT_CPU_INST_ADDR_WIDTH 0x1c
#define ALT_CPU_NAME "cpu"
#define ALT_CPU_NUM_OF_SHADOW_REG_SETS 0
#define ALT_CPU_OCI_VERSION 1
#define ALT_CPU_RESET_ADDR 0x04000000


/*
 * CPU configuration (with legacy prefix - don't use these anymore)
 *
 */

#define NIOS2_BIG_ENDIAN 0
#define NIOS2_BREAK_ADDR 0x08010820
#define NIOS2_CPU_ARCH_NIOS2_R1
#define NIOS2_CPU_FREQ 50000000u
#define NIOS2_CPU_ID_SIZE 1
#define NIOS2_CPU_ID_VALUE 0x00000001
#define NIOS2_CPU_IMPLEMENTATION "fast"
#define NIOS2_DATA_ADDR_WIDTH 0x1c
#define NIOS2_DCACHE_LINE_SIZE 0
#define NIOS2_DCACHE_LINE_SIZE_LOG2 0
#define NIOS2_DCACHE_SIZE 0
#define NIOS2_EXCEPTION_ADDR 0x04000020
#define NIOS2_FLASH_ACCELERATOR_LINES 0
#define NIOS2_FLASH_ACCELERATOR_LINE_SIZE 0
#define NIOS2_FLUSHDA_SUPPORTED
#define NIOS2_HARDWARE_DIVIDE_PRESENT 0
#define NIOS2_HARDWARE_MULTIPLY_PRESENT 1
#define NIOS2_HARDWARE_MULX_PRESENT 0
#define NIOS2_HAS_DEBUG_CORE 1
#define NIOS2_HAS_DEBUG_STUB
#define NIOS2_HAS_EXTRA_EXCEPTION_INFO
#define NIOS2_HAS_ILLEGAL_INSTRUCTION_EXCEPTION
#define NIOS2_HAS_JMPI_INSTRUCTION
#define NIOS2_ICACHE_LINE_SIZE 0
#define NIOS2_ICACHE_LINE_SIZE_LOG2 0
#define NIOS2_ICACHE_SIZE 0
#define NIOS2_INST_ADDR_WIDTH 0x1c
#define NIOS2_NUM_OF_SHADOW_REG_SETS 0
#define NIOS2_OCI_VERSION 1
#define NIOS2_RESET_ADDR 0x04000000


/*
 * Define for each module class mastered by the CPU
 *
 */

#define __ALTERA_AVALON_JTAG_UART
#define __ALTERA_AVALON_NEW_SDRAM_CONTROLLER
#define __ALTERA_AVALON_ONCHIP_MEMORY2
#define __ALTERA_AVALON_PIO
#define __ALTERA_AVALON_TIMER
#define __ALTERA_NIOS2_GEN2
#define __ALTERA_UP_AVALON_VIDEO_CHARACTER_BUFFER_WITH_DMA
#define __AVALON_NOC_ADAPTER_PD


/*
 * LED_pio configuration
 *
 */

#define ALT_MODULE_CLASS_LED_pio altera_avalon_pio
#define LED_PIO_BASE 0x8011050
#define LED_PIO_BIT_CLEARING_EDGE_REGISTER 0
#define LED_PIO_BIT_MODIFYING_OUTPUT_REGISTER 0
#define LED_PIO_CAPTURE 0
#define LED_PIO_DATA_WIDTH 8
#define LED_PIO_DO_TEST_BENCH_WIRING 0
#define LED_PIO_DRIVEN_SIM_VALUE 0
#define LED_PIO_EDGE_TYPE "NONE"
#define LED_PIO_FREQ 50000000
#define LED_PIO_HAS_IN 0
#define LED_PIO_HAS_OUT 1
#define LED_PIO_HAS_TRI 0
#define LED_PIO_IRQ -1
#define LED_PIO_IRQ_INTERRUPT_CONTROLLER_ID -1
#define LED_PIO_IRQ_TYPE "NONE"
#define LED_PIO_NAME "/dev/LED_pio"
#define LED_PIO_RESET_VALUE 0
#define LED_PIO_SPAN 16
#define LED_PIO_TYPE "altera_avalon_pio"


/*
 * System configuration
 *
 */

#define ALT_DEVICE_FAMILY "Cyclone V"
#define ALT_ENHANCED_INTERRUPT_API_PRESENT
#define ALT_IRQ_BASE NULL
#define ALT_LOG_PORT "/dev/null"
#define ALT_LOG_PORT_BASE 0x0
#define ALT_LOG_PORT_DEV null
#define ALT_LOG_PORT_TYPE ""
#define ALT_NUM_EXTERNAL_INTERRUPT_CONTROLLERS 0
#define ALT_NUM_INTERNAL_INTERRUPT_CONTROLLERS 1
#define ALT_NUM_INTERRUPT_CONTROLLERS 1
#define ALT_STDERR "/dev/jtag_uart"
#define ALT_STDERR_BASE 0x8011060
#define ALT_STDERR_DEV jtag_uart
#define ALT_STDERR_IS_JTAG_UART
#define ALT_STDERR_PRESENT
#define ALT_STDERR_TYPE "altera_avalon_jtag_uart"
#define ALT_STDIN "/dev/jtag_uart"
#define ALT_STDIN_BASE 0x8011060
#define ALT_STDIN_DEV jtag_uart
#define ALT_STDIN_IS_JTAG_UART
#define ALT_STDIN_PRESENT
#define ALT_STDIN_TYPE "altera_avalon_jtag_uart"
#define ALT_STDOUT "/dev/jtag_uart"
#define ALT_STDOUT_BASE 0x8011060
#define ALT_STDOUT_DEV jtag_uart
#define ALT_STDOUT_IS_JTAG_UART
#define ALT_STDOUT_PRESENT
#define ALT_STDOUT_TYPE "altera_avalon_jtag_uart"
#define ALT_SYSTEM_NAME "Nios_System_2A"


/*
 * avalon_noc_adapter_pd_0 configuration
 *
 */

#define ALT_MODULE_CLASS_avalon_noc_adapter_pd_0 avalon_noc_adapter_pd
#define AVALON_NOC_ADAPTER_PD_0_BASE 0x8011000
#define AVALON_NOC_ADAPTER_PD_0_IRQ 3
#define AVALON_NOC_ADAPTER_PD_0_IRQ_INTERRUPT_CONTROLLER_ID 0
#define AVALON_NOC_ADAPTER_PD_0_NAME "/dev/avalon_noc_adapter_pd_0"
#define AVALON_NOC_ADAPTER_PD_0_SPAN 32
#define AVALON_NOC_ADAPTER_PD_0_TYPE "avalon_noc_adapter_pd"


/*
 * hal configuration
 *
 */

#define ALT_INCLUDE_INSTRUCTION_RELATED_EXCEPTION_API
#define ALT_MAX_FD 32
#define ALT_SYS_CLK HIGH_RES_TIMER
#define ALT_TIMESTAMP_CLK none


/*
 * high_res_timer configuration
 *
 */

#define ALT_MODULE_CLASS_high_res_timer altera_avalon_timer
#define HIGH_RES_TIMER_ALWAYS_RUN 0
#define HIGH_RES_TIMER_BASE 0x8011020
#define HIGH_RES_TIMER_COUNTER_SIZE 32
#define HIGH_RES_TIMER_FIXED_PERIOD 0
#define HIGH_RES_TIMER_FREQ 50000000
#define HIGH_RES_TIMER_IRQ 0
#define HIGH_RES_TIMER_IRQ_INTERRUPT_CONTROLLER_ID 0
#define HIGH_RES_TIMER_LOAD_VALUE 49999
#define HIGH_RES_TIMER_MULT 0.001
#define HIGH_RES_TIMER_NAME "/dev/high_res_timer"
#define HIGH_RES_TIMER_PERIOD 1
#define HIGH_RES_TIMER_PERIOD_UNITS "ms"
#define HIGH_RES_TIMER_RESET_OUTPUT 0
#define HIGH_RES_TIMER_SNAPSHOT 1
#define HIGH_RES_TIMER_SPAN 32
#define HIGH_RES_TIMER_TICKS_PER_SEC 1000
#define HIGH_RES_TIMER_TIMEOUT_PULSE_OUTPUT 0
#define HIGH_RES_TIMER_TYPE "altera_avalon_timer"


/*
 * jtag_uart configuration
 *
 */

#define ALT_MODULE_CLASS_jtag_uart altera_avalon_jtag_uart
#define JTAG_UART_BASE 0x8011060
#define JTAG_UART_IRQ 1
#define JTAG_UART_IRQ_INTERRUPT_CONTROLLER_ID 0
#define JTAG_UART_NAME "/dev/jtag_uart"
#define JTAG_UART_READ_DEPTH 64
#define JTAG_UART_READ_THRESHOLD 8
#define JTAG_UART_SPAN 8
#define JTAG_UART_TYPE "altera_avalon_jtag_uart"
#define JTAG_UART_WRITE_DEPTH 64
#define JTAG_UART_WRITE_THRESHOLD 8


/*
 * onchip_memory configuration
 *
 */

#define ALT_MODULE_CLASS_onchip_memory altera_avalon_onchip_memory2
#define ONCHIP_MEMORY_ALLOW_IN_SYSTEM_MEMORY_CONTENT_EDITOR 0
#define ONCHIP_MEMORY_ALLOW_MRAM_SIM_CONTENTS_ONLY_FILE 0
#define ONCHIP_MEMORY_BASE 0x8008000
#define ONCHIP_MEMORY_CONTENTS_INFO ""
#define ONCHIP_MEMORY_DUAL_PORT 0
#define ONCHIP_MEMORY_GUI_RAM_BLOCK_TYPE "AUTO"
#define ONCHIP_MEMORY_INIT_CONTENTS_FILE "Nios_System_2A_onchip_memory"
#define ONCHIP_MEMORY_INIT_MEM_CONTENT 1
#define ONCHIP_MEMORY_INSTANCE_ID "NONE"
#define ONCHIP_MEMORY_IRQ -1
#define ONCHIP_MEMORY_IRQ_INTERRUPT_CONTROLLER_ID -1
#define ONCHIP_MEMORY_NAME "/dev/onchip_memory"
#define ONCHIP_MEMORY_NON_DEFAULT_INIT_FILE_ENABLED 0
#define ONCHIP_MEMORY_RAM_BLOCK_TYPE "AUTO"
#define ONCHIP_MEMORY_READ_DURING_WRITE_MODE "DONT_CARE"
#define ONCHIP_MEMORY_SINGLE_CLOCK_OP 0
#define ONCHIP_MEMORY_SIZE_MULTIPLE 1
#define ONCHIP_MEMORY_SIZE_VALUE 20480
#define ONCHIP_MEMORY_SPAN 20480
#define ONCHIP_MEMORY_TYPE "altera_avalon_onchip_memory2"
#define ONCHIP_MEMORY_WRITABLE 1


/*
 * sdram configuration
 *
 */

#define ALT_MODULE_CLASS_sdram altera_avalon_new_sdram_controller
#define SDRAM_BASE 0x4000000
#define SDRAM_CAS_LATENCY 3
#define SDRAM_CONTENTS_INFO
#define SDRAM_INIT_NOP_DELAY 0.0
#define SDRAM_INIT_REFRESH_COMMANDS 2
#define SDRAM_IRQ -1
#define SDRAM_IRQ_INTERRUPT_CONTROLLER_ID -1
#define SDRAM_IS_INITIALIZED 1
#define SDRAM_NAME "/dev/sdram"
#define SDRAM_POWERUP_DELAY 100.0
#define SDRAM_REFRESH_PERIOD 7.8125
#define SDRAM_REGISTER_DATA_IN 1
#define SDRAM_SDRAM_ADDR_WIDTH 0x19
#define SDRAM_SDRAM_BANK_WIDTH 2
#define SDRAM_SDRAM_COL_WIDTH 10
#define SDRAM_SDRAM_DATA_WIDTH 16
#define SDRAM_SDRAM_NUM_BANKS 4
#define SDRAM_SDRAM_NUM_CHIPSELECTS 1
#define SDRAM_SDRAM_ROW_WIDTH 13
#define SDRAM_SHARED_DATA 0
#define SDRAM_SIM_MODEL_BASE 0
#define SDRAM_SPAN 67108864
#define SDRAM_STARVATION_INDICATOR 0
#define SDRAM_TRISTATE_BRIDGE_SLAVE ""
#define SDRAM_TYPE "altera_avalon_new_sdram_controller"
#define SDRAM_T_AC 5.4
#define SDRAM_T_MRD 3
#define SDRAM_T_RCD 15.0
#define SDRAM_T_RFC 70.0
#define SDRAM_T_RP 15.0
#define SDRAM_T_WR 14.0


/*
 * video_character_buffer_with_dma_0_avalon_char_buffer_slave configuration
 *
 */

#define ALT_MODULE_CLASS_video_character_buffer_with_dma_0_avalon_char_buffer_slave altera_up_avalon_video_character_buffer_with_dma
#define VIDEO_CHARACTER_BUFFER_WITH_DMA_0_AVALON_CHAR_BUFFER_SLAVE_BASE 0x8012000
#define VIDEO_CHARACTER_BUFFER_WITH_DMA_0_AVALON_CHAR_BUFFER_SLAVE_IRQ -1
#define VIDEO_CHARACTER_BUFFER_WITH_DMA_0_AVALON_CHAR_BUFFER_SLAVE_IRQ_INTERRUPT_CONTROLLER_ID -1
#define VIDEO_CHARACTER_BUFFER_WITH_DMA_0_AVALON_CHAR_BUFFER_SLAVE_NAME "/dev/video_character_buffer_with_dma_0_avalon_char_buffer_slave"
#define VIDEO_CHARACTER_BUFFER_WITH_DMA_0_AVALON_CHAR_BUFFER_SLAVE_SPAN 8192
#define VIDEO_CHARACTER_BUFFER_WITH_DMA_0_AVALON_CHAR_BUFFER_SLAVE_TYPE "altera_up_avalon_video_character_buffer_with_dma"


/*
 * video_character_buffer_with_dma_0_avalon_char_control_slave configuration
 *
 */

#define ALT_MODULE_CLASS_video_character_buffer_with_dma_0_avalon_char_control_slave altera_up_avalon_video_character_buffer_with_dma
#define VIDEO_CHARACTER_BUFFER_WITH_DMA_0_AVALON_CHAR_CONTROL_SLAVE_BASE 0x8011070
#define VIDEO_CHARACTER_BUFFER_WITH_DMA_0_AVALON_CHAR_CONTROL_SLAVE_IRQ -1
#define VIDEO_CHARACTER_BUFFER_WITH_DMA_0_AVALON_CHAR_CONTROL_SLAVE_IRQ_INTERRUPT_CONTROLLER_ID -1
#define VIDEO_CHARACTER_BUFFER_WITH_DMA_0_AVALON_CHAR_CONTROL_SLAVE_NAME "/dev/video_character_buffer_with_dma_0_avalon_char_control_slave"
#define VIDEO_CHARACTER_BUFFER_WITH_DMA_0_AVALON_CHAR_CONTROL_SLAVE_SPAN 8
#define VIDEO_CHARACTER_BUFFER_WITH_DMA_0_AVALON_CHAR_CONTROL_SLAVE_TYPE "altera_up_avalon_video_character_buffer_with_dma"

#endif /* __SYSTEM_H_ */
