TonnyChenProgramming/701/nios_support/quartus/Nios_System_2A/synthesis/Nios_System_2A.vhd

-- Nios_System_2A.vhd

-- Generated using ACDS version 18.1 625

library IEEE;
use IEEE.std_logic_1164.all;
use IEEE.numeric_std.all;

entity Nios_System_2A is
	port (
		button_pio_external_connection_export           : in    std_logic_vector(1 downto 0)  := (others => '0'); --            button_pio_external_connection.export
		clocks_ref_clk_clk                              : in    std_logic                     := '0';             --                            clocks_ref_clk.clk
		clocks_ref_reset_reset                          : in    std_logic                     := '0';             --                          clocks_ref_reset.reset
		clocks_sys_clk_export                           : out   std_logic;                                        --                     clocks_sys_clk_export.clk
		clocks_sdram_clk_clk                            : out   std_logic;                                        --                          clocks_sdram_clk.clk
		led_pio_external_connection_export              : out   std_logic_vector(7 downto 0);                     --               led_pio_external_connection.export
		noc_recv_addr                                   : in    std_logic_vector(7 downto 0)  := (others => '0'); --                                  noc_recv.addr
		noc_recv_data                                   : in    std_logic_vector(31 downto 0) := (others => '0'); --                                          .data
		noc_send_addr                                   : out   std_logic_vector(7 downto 0);                     --                                  noc_send.addr
		noc_send_data                                   : out   std_logic_vector(31 downto 0);                    --                                          .data
		sdram_wire_addr                                 : out   std_logic_vector(12 downto 0);                    --                                sdram_wire.addr
		sdram_wire_ba                                   : out   std_logic_vector(1 downto 0);                     --                                          .ba
		sdram_wire_cas_n                                : out   std_logic;                                        --                                          .cas_n
		sdram_wire_cke                                  : out   std_logic;                                        --                                          .cke
		sdram_wire_cs_n                                 : out   std_logic;                                        --                                          .cs_n
		sdram_wire_dq                                   : inout std_logic_vector(15 downto 0) := (others => '0'); --                                          .dq
		sdram_wire_dqm                                  : out   std_logic_vector(1 downto 0);                     --                                          .dqm
		sdram_wire_ras_n                                : out   std_logic;                                        --                                          .ras_n
		sdram_wire_we_n                                 : out   std_logic;                                        --                                          .we_n
		video_vga_controller_0_external_interface_CLK   : out   std_logic;                                        -- video_vga_controller_0_external_interface.CLK
		video_vga_controller_0_external_interface_HS    : out   std_logic;                                        --                                          .HS
		video_vga_controller_0_external_interface_VS    : out   std_logic;                                        --                                          .VS
		video_vga_controller_0_external_interface_BLANK : out   std_logic;                                        --                                          .BLANK
		video_vga_controller_0_external_interface_SYNC  : out   std_logic;                                        --                                          .SYNC
		video_vga_controller_0_external_interface_R     : out   std_logic_vector(7 downto 0);                     --                                          .R
		video_vga_controller_0_external_interface_G     : out   std_logic_vector(7 downto 0);                     --                                          .G
		video_vga_controller_0_external_interface_B     : out   std_logic_vector(7 downto 0)                      --                                          .B
	);
end entity Nios_System_2A;

architecture rtl of Nios_System_2A is
	component Nios_System_2A_BUTTON_pio is
		port (
			clk        : in  std_logic                     := 'X';             -- clk
			reset_n    : in  std_logic                     := 'X';             -- reset_n
			address    : in  std_logic_vector(1 downto 0)  := (others => 'X'); -- address
			write_n    : in  std_logic                     := 'X';             -- write_n
			writedata  : in  std_logic_vector(31 downto 0) := (others => 'X'); -- writedata
			chipselect : in  std_logic                     := 'X';             -- chipselect
			readdata   : out std_logic_vector(31 downto 0);                    -- readdata
			in_port    : in  std_logic_vector(1 downto 0)  := (others => 'X'); -- export
			irq        : out std_logic                                         -- irq
		);
	end component Nios_System_2A_BUTTON_pio;

	component Nios_System_2A_LED_pio is
		port (
			clk        : in  std_logic                     := 'X';             -- clk
			reset_n    : in  std_logic                     := 'X';             -- reset_n
			address    : in  std_logic_vector(1 downto 0)  := (others => 'X'); -- address
			write_n    : in  std_logic                     := 'X';             -- write_n
			writedata  : in  std_logic_vector(31 downto 0) := (others => 'X'); -- writedata
			chipselect : in  std_logic                     := 'X';             -- chipselect
			readdata   : out std_logic_vector(31 downto 0);                    -- readdata
			out_port   : out std_logic_vector(7 downto 0)                      -- export
		);
	end component Nios_System_2A_LED_pio;

	component avalon_noc_adapter_pd is
		port (
			clk           : in  std_logic                     := 'X';             -- clk
			reset         : in  std_logic                     := 'X';             -- reset
			avs_address   : in  std_logic_vector(2 downto 0)  := (others => 'X'); -- address
			avs_read      : in  std_logic                     := 'X';             -- read
			avs_write     : in  std_logic                     := 'X';             -- write
			avs_writedata : in  std_logic_vector(31 downto 0) := (others => 'X'); -- writedata
			avs_readdata  : out std_logic_vector(31 downto 0);                    -- readdata
			irq           : out std_logic;                                        -- irq
			noc_send_addr : out std_logic_vector(7 downto 0);                     -- addr
			noc_send_data : out std_logic_vector(31 downto 0);                    -- data
			noc_recv_addr : in  std_logic_vector(7 downto 0)  := (others => 'X'); -- addr
			noc_recv_data : in  std_logic_vector(31 downto 0) := (others => 'X')  -- data
		);
	end component avalon_noc_adapter_pd;

	component Nios_System_2A_clocks is
		port (
			ref_clk_clk        : in  std_logic := 'X'; -- clk
			ref_reset_reset    : in  std_logic := 'X'; -- reset
			sys_clk_clk        : out std_logic;        -- clk
			sdram_clk_clk      : out std_logic;        -- clk
			reset_source_reset : out std_logic         -- reset
		);
	end component Nios_System_2A_clocks;

	component Nios_System_2A_cpu is
		port (
			clk                                 : in  std_logic                     := 'X';             -- clk
			reset_n                             : in  std_logic                     := 'X';             -- reset_n
			reset_req                           : in  std_logic                     := 'X';             -- reset_req
			d_address                           : out std_logic_vector(27 downto 0);                    -- address
			d_byteenable                        : out std_logic_vector(3 downto 0);                     -- byteenable
			d_read                              : out std_logic;                                        -- read
			d_readdata                          : in  std_logic_vector(31 downto 0) := (others => 'X'); -- readdata
			d_waitrequest                       : in  std_logic                     := 'X';             -- waitrequest
			d_write                             : out std_logic;                                        -- write
			d_writedata                         : out std_logic_vector(31 downto 0);                    -- writedata
			debug_mem_slave_debugaccess_to_roms : out std_logic;                                        -- debugaccess
			i_address                           : out std_logic_vector(27 downto 0);                    -- address
			i_read                              : out std_logic;                                        -- read
			i_readdata                          : in  std_logic_vector(31 downto 0) := (others => 'X'); -- readdata
			i_waitrequest                       : in  std_logic                     := 'X';             -- waitrequest
			irq                                 : in  std_logic_vector(31 downto 0) := (others => 'X'); -- irq
			debug_reset_request                 : out std_logic;                                        -- reset
			debug_mem_slave_address             : in  std_logic_vector(8 downto 0)  := (others => 'X'); -- address
			debug_mem_slave_byteenable          : in  std_logic_vector(3 downto 0)  := (others => 'X'); -- byteenable
			debug_mem_slave_debugaccess         : in  std_logic                     := 'X';             -- debugaccess
			debug_mem_slave_read                : in  std_logic                     := 'X';             -- read
			debug_mem_slave_readdata            : out std_logic_vector(31 downto 0);                    -- readdata
			debug_mem_slave_waitrequest         : out std_logic;                                        -- waitrequest
			debug_mem_slave_write               : in  std_logic                     := 'X';             -- write
			debug_mem_slave_writedata           : in  std_logic_vector(31 downto 0) := (others => 'X'); -- writedata
			dummy_ci_port                       : out std_logic                                         -- readra
		);
	end component Nios_System_2A_cpu;

	component Nios_System_2A_high_res_timer is
		port (
			clk        : in  std_logic                     := 'X';             -- clk
			reset_n    : in  std_logic                     := 'X';             -- reset_n
			address    : in  std_logic_vector(2 downto 0)  := (others => 'X'); -- address
			writedata  : in  std_logic_vector(15 downto 0) := (others => 'X'); -- writedata
			readdata   : out std_logic_vector(15 downto 0);                    -- readdata
			chipselect : in  std_logic                     := 'X';             -- chipselect
			write_n    : in  std_logic                     := 'X';             -- write_n
			irq        : out std_logic                                         -- irq
		);
	end component Nios_System_2A_high_res_timer;

	component Nios_System_2A_jtag_uart is
		port (
			clk            : in  std_logic                     := 'X';             -- clk
			rst_n          : in  std_logic                     := 'X';             -- reset_n
			av_chipselect  : in  std_logic                     := 'X';             -- chipselect
			av_address     : in  std_logic                     := 'X';             -- address
			av_read_n      : in  std_logic                     := 'X';             -- read_n
			av_readdata    : out std_logic_vector(31 downto 0);                    -- readdata
			av_write_n     : in  std_logic                     := 'X';             -- write_n
			av_writedata   : in  std_logic_vector(31 downto 0) := (others => 'X'); -- writedata
			av_waitrequest : out std_logic;                                        -- waitrequest
			av_irq         : out std_logic                                         -- irq
		);
	end component Nios_System_2A_jtag_uart;

	component Nios_System_2A_onchip_memory is
		port (
			clk        : in  std_logic                     := 'X';             -- clk
			address    : in  std_logic_vector(12 downto 0) := (others => 'X'); -- address
			clken      : in  std_logic                     := 'X';             -- clken
			chipselect : in  std_logic                     := 'X';             -- chipselect
			write      : in  std_logic                     := 'X';             -- write
			readdata   : out std_logic_vector(31 downto 0);                    -- readdata
			writedata  : in  std_logic_vector(31 downto 0) := (others => 'X'); -- writedata
			byteenable : in  std_logic_vector(3 downto 0)  := (others => 'X'); -- byteenable
			reset      : in  std_logic                     := 'X';             -- reset
			reset_req  : in  std_logic                     := 'X';             -- reset_req
			freeze     : in  std_logic                     := 'X'              -- freeze
		);
	end component Nios_System_2A_onchip_memory;

	component Nios_System_2A_sdram is
		port (
			clk            : in    std_logic                     := 'X';             -- clk
			reset_n        : in    std_logic                     := 'X';             -- reset_n
			az_addr        : in    std_logic_vector(24 downto 0) := (others => 'X'); -- address
			az_be_n        : in    std_logic_vector(1 downto 0)  := (others => 'X'); -- byteenable_n
			az_cs          : in    std_logic                     := 'X';             -- chipselect
			az_data        : in    std_logic_vector(15 downto 0) := (others => 'X'); -- writedata
			az_rd_n        : in    std_logic                     := 'X';             -- read_n
			az_wr_n        : in    std_logic                     := 'X';             -- write_n
			za_data        : out   std_logic_vector(15 downto 0);                    -- readdata
			za_valid       : out   std_logic;                                        -- readdatavalid
			za_waitrequest : out   std_logic;                                        -- waitrequest
			zs_addr        : out   std_logic_vector(12 downto 0);                    -- export
			zs_ba          : out   std_logic_vector(1 downto 0);                     -- export
			zs_cas_n       : out   std_logic;                                        -- export
			zs_cke         : out   std_logic;                                        -- export
			zs_cs_n        : out   std_logic;                                        -- export
			zs_dq          : inout std_logic_vector(15 downto 0) := (others => 'X'); -- export
			zs_dqm         : out   std_logic_vector(1 downto 0);                     -- export
			zs_ras_n       : out   std_logic;                                        -- export
			zs_we_n        : out   std_logic                                         -- export
		);
	end component Nios_System_2A_sdram;

	component Nios_System_2A_video_character_buffer_with_dma_0 is
		port (
			clk                  : in  std_logic                     := 'X';             -- clk
			reset                : in  std_logic                     := 'X';             -- reset
			ctrl_address         : in  std_logic                     := 'X';             -- address
			ctrl_byteenable      : in  std_logic_vector(3 downto 0)  := (others => 'X'); -- byteenable
			ctrl_chipselect      : in  std_logic                     := 'X';             -- chipselect
			ctrl_read            : in  std_logic                     := 'X';             -- read
			ctrl_write           : in  std_logic                     := 'X';             -- write
			ctrl_writedata       : in  std_logic_vector(31 downto 0) := (others => 'X'); -- writedata
			ctrl_readdata        : out std_logic_vector(31 downto 0);                    -- readdata
			buf_byteenable       : in  std_logic                     := 'X';             -- byteenable
			buf_chipselect       : in  std_logic                     := 'X';             -- chipselect
			buf_read             : in  std_logic                     := 'X';             -- read
			buf_write            : in  std_logic                     := 'X';             -- write
			buf_writedata        : in  std_logic_vector(7 downto 0)  := (others => 'X'); -- writedata
			buf_readdata         : out std_logic_vector(7 downto 0);                     -- readdata
			buf_waitrequest      : out std_logic;                                        -- waitrequest
			buf_address          : in  std_logic_vector(12 downto 0) := (others => 'X'); -- address
			stream_ready         : in  std_logic                     := 'X';             -- ready
			stream_startofpacket : out std_logic;                                        -- startofpacket
			stream_endofpacket   : out std_logic;                                        -- endofpacket
			stream_valid         : out std_logic;                                        -- valid
			stream_data          : out std_logic_vector(29 downto 0)                     -- data
		);
	end component Nios_System_2A_video_character_buffer_with_dma_0;

	component Nios_System_2A_video_dual_clock_buffer_0 is
		port (
			clk_stream_in            : in  std_logic                     := 'X';             -- clk
			reset_stream_in          : in  std_logic                     := 'X';             -- reset
			clk_stream_out           : in  std_logic                     := 'X';             -- clk
			reset_stream_out         : in  std_logic                     := 'X';             -- reset
			stream_in_ready          : out std_logic;                                        -- ready
			stream_in_startofpacket  : in  std_logic                     := 'X';             -- startofpacket
			stream_in_endofpacket    : in  std_logic                     := 'X';             -- endofpacket
			stream_in_valid          : in  std_logic                     := 'X';             -- valid
			stream_in_data           : in  std_logic_vector(29 downto 0) := (others => 'X'); -- data
			stream_out_ready         : in  std_logic                     := 'X';             -- ready
			stream_out_startofpacket : out std_logic;                                        -- startofpacket
			stream_out_endofpacket   : out std_logic;                                        -- endofpacket
			stream_out_valid         : out std_logic;                                        -- valid
			stream_out_data          : out std_logic_vector(29 downto 0)                     -- data
		);
	end component Nios_System_2A_video_dual_clock_buffer_0;

	component Nios_System_2A_video_pll_0 is
		port (
			ref_clk_clk        : in  std_logic := 'X'; -- clk
			ref_reset_reset    : in  std_logic := 'X'; -- reset
			vga_clk_clk        : out std_logic;        -- clk
			reset_source_reset : out std_logic         -- reset
		);
	end component Nios_System_2A_video_pll_0;

	component Nios_System_2A_video_vga_controller_0 is
		port (
			clk           : in  std_logic                     := 'X';             -- clk
			reset         : in  std_logic                     := 'X';             -- reset
			data          : in  std_logic_vector(29 downto 0) := (others => 'X'); -- data
			startofpacket : in  std_logic                     := 'X';             -- startofpacket
			endofpacket   : in  std_logic                     := 'X';             -- endofpacket
			valid         : in  std_logic                     := 'X';             -- valid
			ready         : out std_logic;                                        -- ready
			VGA_CLK       : out std_logic;                                        -- export
			VGA_HS        : out std_logic;                                        -- export
			VGA_VS        : out std_logic;                                        -- export
			VGA_BLANK     : out std_logic;                                        -- export
			VGA_SYNC      : out std_logic;                                        -- export
			VGA_R         : out std_logic_vector(7 downto 0);                     -- export
			VGA_G         : out std_logic_vector(7 downto 0);                     -- export
			VGA_B         : out std_logic_vector(7 downto 0)                      -- export
		);
	end component Nios_System_2A_video_vga_controller_0;

	component Nios_System_2A_mm_interconnect_0 is
		port (
			clocks_sys_clk_clk                                                     : in  std_logic                     := 'X';             -- clk
			avalon_noc_adapter_pd_0_reset_reset_bridge_in_reset_reset              : in  std_logic                     := 'X';             -- reset
			cpu_reset_reset_bridge_in_reset_reset                                  : in  std_logic                     := 'X';             -- reset
			cpu_data_master_address                                                : in  std_logic_vector(27 downto 0) := (others => 'X'); -- address
			cpu_data_master_waitrequest                                            : out std_logic;                                        -- waitrequest
			cpu_data_master_byteenable                                             : in  std_logic_vector(3 downto 0)  := (others => 'X'); -- byteenable
			cpu_data_master_read                                                   : in  std_logic                     := 'X';             -- read
			cpu_data_master_readdata                                               : out std_logic_vector(31 downto 0);                    -- readdata
			cpu_data_master_write                                                  : in  std_logic                     := 'X';             -- write
			cpu_data_master_writedata                                              : in  std_logic_vector(31 downto 0) := (others => 'X'); -- writedata
			cpu_data_master_debugaccess                                            : in  std_logic                     := 'X';             -- debugaccess
			cpu_instruction_master_address                                         : in  std_logic_vector(27 downto 0) := (others => 'X'); -- address
			cpu_instruction_master_waitrequest                                     : out std_logic;                                        -- waitrequest
			cpu_instruction_master_read                                            : in  std_logic                     := 'X';             -- read
			cpu_instruction_master_readdata                                        : out std_logic_vector(31 downto 0);                    -- readdata
			avalon_noc_adapter_pd_0_avs_address                                    : out std_logic_vector(2 downto 0);                     -- address
			avalon_noc_adapter_pd_0_avs_write                                      : out std_logic;                                        -- write
			avalon_noc_adapter_pd_0_avs_read                                       : out std_logic;                                        -- read
			avalon_noc_adapter_pd_0_avs_readdata                                   : in  std_logic_vector(31 downto 0) := (others => 'X'); -- readdata
			avalon_noc_adapter_pd_0_avs_writedata                                  : out std_logic_vector(31 downto 0);                    -- writedata
			BUTTON_pio_s1_address                                                  : out std_logic_vector(1 downto 0);                     -- address
			BUTTON_pio_s1_write                                                    : out std_logic;                                        -- write
			BUTTON_pio_s1_readdata                                                 : in  std_logic_vector(31 downto 0) := (others => 'X'); -- readdata
			BUTTON_pio_s1_writedata                                                : out std_logic_vector(31 downto 0);                    -- writedata
			BUTTON_pio_s1_chipselect                                               : out std_logic;                                        -- chipselect
			cpu_debug_mem_slave_address                                            : out std_logic_vector(8 downto 0);                     -- address
			cpu_debug_mem_slave_write                                              : out std_logic;                                        -- write
			cpu_debug_mem_slave_read                                               : out std_logic;                                        -- read
			cpu_debug_mem_slave_readdata                                           : in  std_logic_vector(31 downto 0) := (others => 'X'); -- readdata
			cpu_debug_mem_slave_writedata                                          : out std_logic_vector(31 downto 0);                    -- writedata
			cpu_debug_mem_slave_byteenable                                         : out std_logic_vector(3 downto 0);                     -- byteenable
			cpu_debug_mem_slave_waitrequest                                        : in  std_logic                     := 'X';             -- waitrequest
			cpu_debug_mem_slave_debugaccess                                        : out std_logic;                                        -- debugaccess
			high_res_timer_s1_address                                              : out std_logic_vector(2 downto 0);                     -- address
			high_res_timer_s1_write                                                : out std_logic;                                        -- write
			high_res_timer_s1_readdata                                             : in  std_logic_vector(15 downto 0) := (others => 'X'); -- readdata
			high_res_timer_s1_writedata                                            : out std_logic_vector(15 downto 0);                    -- writedata
			high_res_timer_s1_chipselect                                           : out std_logic;                                        -- chipselect
			jtag_uart_avalon_jtag_slave_address                                    : out std_logic_vector(0 downto 0);                     -- address
			jtag_uart_avalon_jtag_slave_write                                      : out std_logic;                                        -- write
			jtag_uart_avalon_jtag_slave_read                                       : out std_logic;                                        -- read
			jtag_uart_avalon_jtag_slave_readdata                                   : in  std_logic_vector(31 downto 0) := (others => 'X'); -- readdata
			jtag_uart_avalon_jtag_slave_writedata                                  : out std_logic_vector(31 downto 0);                    -- writedata
			jtag_uart_avalon_jtag_slave_waitrequest                                : in  std_logic                     := 'X';             -- waitrequest
			jtag_uart_avalon_jtag_slave_chipselect                                 : out std_logic;                                        -- chipselect
			LED_pio_s1_address                                                     : out std_logic_vector(1 downto 0);                     -- address
			LED_pio_s1_write                                                       : out std_logic;                                        -- write
			LED_pio_s1_readdata                                                    : in  std_logic_vector(31 downto 0) := (others => 'X'); -- readdata
			LED_pio_s1_writedata                                                   : out std_logic_vector(31 downto 0);                    -- writedata
			LED_pio_s1_chipselect                                                  : out std_logic;                                        -- chipselect
			onchip_memory_s1_address                                               : out std_logic_vector(12 downto 0);                    -- address
			onchip_memory_s1_write                                                 : out std_logic;                                        -- write
			onchip_memory_s1_readdata                                              : in  std_logic_vector(31 downto 0) := (others => 'X'); -- readdata
			onchip_memory_s1_writedata                                             : out std_logic_vector(31 downto 0);                    -- writedata
			onchip_memory_s1_byteenable                                            : out std_logic_vector(3 downto 0);                     -- byteenable
			onchip_memory_s1_chipselect                                            : out std_logic;                                        -- chipselect
			onchip_memory_s1_clken                                                 : out std_logic;                                        -- clken
			sdram_s1_address                                                       : out std_logic_vector(24 downto 0);                    -- address
			sdram_s1_write                                                         : out std_logic;                                        -- write
			sdram_s1_read                                                          : out std_logic;                                        -- read
			sdram_s1_readdata                                                      : in  std_logic_vector(15 downto 0) := (others => 'X'); -- readdata
			sdram_s1_writedata                                                     : out std_logic_vector(15 downto 0);                    -- writedata
			sdram_s1_byteenable                                                    : out std_logic_vector(1 downto 0);                     -- byteenable
			sdram_s1_readdatavalid                                                 : in  std_logic                     := 'X';             -- readdatavalid
			sdram_s1_waitrequest                                                   : in  std_logic                     := 'X';             -- waitrequest
			sdram_s1_chipselect                                                    : out std_logic;                                        -- chipselect
			video_character_buffer_with_dma_0_avalon_char_buffer_slave_address     : out std_logic_vector(12 downto 0);                    -- address
			video_character_buffer_with_dma_0_avalon_char_buffer_slave_write       : out std_logic;                                        -- write
			video_character_buffer_with_dma_0_avalon_char_buffer_slave_read        : out std_logic;                                        -- read
			video_character_buffer_with_dma_0_avalon_char_buffer_slave_readdata    : in  std_logic_vector(7 downto 0)  := (others => 'X'); -- readdata
			video_character_buffer_with_dma_0_avalon_char_buffer_slave_writedata   : out std_logic_vector(7 downto 0);                     -- writedata
			video_character_buffer_with_dma_0_avalon_char_buffer_slave_byteenable  : out std_logic_vector(0 downto 0);                     -- byteenable
			video_character_buffer_with_dma_0_avalon_char_buffer_slave_waitrequest : in  std_logic                     := 'X';             -- waitrequest
			video_character_buffer_with_dma_0_avalon_char_buffer_slave_chipselect  : out std_logic;                                        -- chipselect
			video_character_buffer_with_dma_0_avalon_char_control_slave_address    : out std_logic_vector(0 downto 0);                     -- address
			video_character_buffer_with_dma_0_avalon_char_control_slave_write      : out std_logic;                                        -- write
			video_character_buffer_with_dma_0_avalon_char_control_slave_read       : out std_logic;                                        -- read
			video_character_buffer_with_dma_0_avalon_char_control_slave_readdata   : in  std_logic_vector(31 downto 0) := (others => 'X'); -- readdata
			video_character_buffer_with_dma_0_avalon_char_control_slave_writedata  : out std_logic_vector(31 downto 0);                    -- writedata
			video_character_buffer_with_dma_0_avalon_char_control_slave_byteenable : out std_logic_vector(3 downto 0);                     -- byteenable
			video_character_buffer_with_dma_0_avalon_char_control_slave_chipselect : out std_logic                                         -- chipselect
		);
	end component Nios_System_2A_mm_interconnect_0;

	component Nios_System_2A_irq_mapper is
		port (
			clk           : in  std_logic                     := 'X'; -- clk
			reset         : in  std_logic                     := 'X'; -- reset
			receiver0_irq : in  std_logic                     := 'X'; -- irq
			receiver1_irq : in  std_logic                     := 'X'; -- irq
			receiver2_irq : in  std_logic                     := 'X'; -- irq
			receiver3_irq : in  std_logic                     := 'X'; -- irq
			sender_irq    : out std_logic_vector(31 downto 0)         -- irq
		);
	end component Nios_System_2A_irq_mapper;

	component nios_system_2a_rst_controller is
		generic (
			NUM_RESET_INPUTS          : integer := 6;
			OUTPUT_RESET_SYNC_EDGES   : string  := "deassert";
			SYNC_DEPTH                : integer := 2;
			RESET_REQUEST_PRESENT     : integer := 0;
			RESET_REQ_WAIT_TIME       : integer := 1;
			MIN_RST_ASSERTION_TIME    : integer := 3;
			RESET_REQ_EARLY_DSRT_TIME : integer := 1;
			USE_RESET_REQUEST_IN0     : integer := 0;
			USE_RESET_REQUEST_IN1     : integer := 0;
			USE_RESET_REQUEST_IN2     : integer := 0;
			USE_RESET_REQUEST_IN3     : integer := 0;
			USE_RESET_REQUEST_IN4     : integer := 0;
			USE_RESET_REQUEST_IN5     : integer := 0;
			USE_RESET_REQUEST_IN6     : integer := 0;
			USE_RESET_REQUEST_IN7     : integer := 0;
			USE_RESET_REQUEST_IN8     : integer := 0;
			USE_RESET_REQUEST_IN9     : integer := 0;
			USE_RESET_REQUEST_IN10    : integer := 0;
			USE_RESET_REQUEST_IN11    : integer := 0;
			USE_RESET_REQUEST_IN12    : integer := 0;
			USE_RESET_REQUEST_IN13    : integer := 0;
			USE_RESET_REQUEST_IN14    : integer := 0;
			USE_RESET_REQUEST_IN15    : integer := 0;
			ADAPT_RESET_REQUEST       : integer := 0
		);
		port (
			reset_in0      : in  std_logic := 'X'; -- reset_in0.reset
			clk            : in  std_logic := 'X'; --       clk.clk
			reset_out      : out std_logic;        -- reset_out.reset
			reset_req      : out std_logic;        --          .reset_req
			reset_in1      : in  std_logic := 'X';
			reset_in10     : in  std_logic := 'X';
			reset_in11     : in  std_logic := 'X';
			reset_in12     : in  std_logic := 'X';
			reset_in13     : in  std_logic := 'X';
			reset_in14     : in  std_logic := 'X';
			reset_in15     : in  std_logic := 'X';
			reset_in2      : in  std_logic := 'X';
			reset_in3      : in  std_logic := 'X';
			reset_in4      : in  std_logic := 'X';
			reset_in5      : in  std_logic := 'X';
			reset_in6      : in  std_logic := 'X';
			reset_in7      : in  std_logic := 'X';
			reset_in8      : in  std_logic := 'X';
			reset_in9      : in  std_logic := 'X';
			reset_req_in0  : in  std_logic := 'X';
			reset_req_in1  : in  std_logic := 'X';
			reset_req_in10 : in  std_logic := 'X';
			reset_req_in11 : in  std_logic := 'X';
			reset_req_in12 : in  std_logic := 'X';
			reset_req_in13 : in  std_logic := 'X';
			reset_req_in14 : in  std_logic := 'X';
			reset_req_in15 : in  std_logic := 'X';
			reset_req_in2  : in  std_logic := 'X';
			reset_req_in3  : in  std_logic := 'X';
			reset_req_in4  : in  std_logic := 'X';
			reset_req_in5  : in  std_logic := 'X';
			reset_req_in6  : in  std_logic := 'X';
			reset_req_in7  : in  std_logic := 'X';
			reset_req_in8  : in  std_logic := 'X';
			reset_req_in9  : in  std_logic := 'X'
		);
	end component nios_system_2a_rst_controller;

	component nios_system_2a_rst_controller_001 is
		generic (
			NUM_RESET_INPUTS          : integer := 6;
			OUTPUT_RESET_SYNC_EDGES   : string  := "deassert";
			SYNC_DEPTH                : integer := 2;
			RESET_REQUEST_PRESENT     : integer := 0;
			RESET_REQ_WAIT_TIME       : integer := 1;
			MIN_RST_ASSERTION_TIME    : integer := 3;
			RESET_REQ_EARLY_DSRT_TIME : integer := 1;
			USE_RESET_REQUEST_IN0     : integer := 0;
			USE_RESET_REQUEST_IN1     : integer := 0;
			USE_RESET_REQUEST_IN2     : integer := 0;
			USE_RESET_REQUEST_IN3     : integer := 0;
			USE_RESET_REQUEST_IN4     : integer := 0;
			USE_RESET_REQUEST_IN5     : integer := 0;
			USE_RESET_REQUEST_IN6     : integer := 0;
			USE_RESET_REQUEST_IN7     : integer := 0;
			USE_RESET_REQUEST_IN8     : integer := 0;
			USE_RESET_REQUEST_IN9     : integer := 0;
			USE_RESET_REQUEST_IN10    : integer := 0;
			USE_RESET_REQUEST_IN11    : integer := 0;
			USE_RESET_REQUEST_IN12    : integer := 0;
			USE_RESET_REQUEST_IN13    : integer := 0;
			USE_RESET_REQUEST_IN14    : integer := 0;
			USE_RESET_REQUEST_IN15    : integer := 0;
			ADAPT_RESET_REQUEST       : integer := 0
		);
		port (
			reset_in0      : in  std_logic := 'X'; -- reset_in0.reset
			clk            : in  std_logic := 'X'; --       clk.clk
			reset_out      : out std_logic;        -- reset_out.reset
			reset_in1      : in  std_logic := 'X';
			reset_in10     : in  std_logic := 'X';
			reset_in11     : in  std_logic := 'X';
			reset_in12     : in  std_logic := 'X';
			reset_in13     : in  std_logic := 'X';
			reset_in14     : in  std_logic := 'X';
			reset_in15     : in  std_logic := 'X';
			reset_in2      : in  std_logic := 'X';
			reset_in3      : in  std_logic := 'X';
			reset_in4      : in  std_logic := 'X';
			reset_in5      : in  std_logic := 'X';
			reset_in6      : in  std_logic := 'X';
			reset_in7      : in  std_logic := 'X';
			reset_in8      : in  std_logic := 'X';
			reset_in9      : in  std_logic := 'X';
			reset_req      : out std_logic;
			reset_req_in0  : in  std_logic := 'X';
			reset_req_in1  : in  std_logic := 'X';
			reset_req_in10 : in  std_logic := 'X';
			reset_req_in11 : in  std_logic := 'X';
			reset_req_in12 : in  std_logic := 'X';
			reset_req_in13 : in  std_logic := 'X';
			reset_req_in14 : in  std_logic := 'X';
			reset_req_in15 : in  std_logic := 'X';
			reset_req_in2  : in  std_logic := 'X';
			reset_req_in3  : in  std_logic := 'X';
			reset_req_in4  : in  std_logic := 'X';
			reset_req_in5  : in  std_logic := 'X';
			reset_req_in6  : in  std_logic := 'X';
			reset_req_in7  : in  std_logic := 'X';
			reset_req_in8  : in  std_logic := 'X';
			reset_req_in9  : in  std_logic := 'X'
		);
	end component nios_system_2a_rst_controller_001;

	component nios_system_2a_rst_controller_003 is
		generic (
			NUM_RESET_INPUTS          : integer := 6;
			OUTPUT_RESET_SYNC_EDGES   : string  := "deassert";
			SYNC_DEPTH                : integer := 2;
			RESET_REQUEST_PRESENT     : integer := 0;
			RESET_REQ_WAIT_TIME       : integer := 1;
			MIN_RST_ASSERTION_TIME    : integer := 3;
			RESET_REQ_EARLY_DSRT_TIME : integer := 1;
			USE_RESET_REQUEST_IN0     : integer := 0;
			USE_RESET_REQUEST_IN1     : integer := 0;
			USE_RESET_REQUEST_IN2     : integer := 0;
			USE_RESET_REQUEST_IN3     : integer := 0;
			USE_RESET_REQUEST_IN4     : integer := 0;
			USE_RESET_REQUEST_IN5     : integer := 0;
			USE_RESET_REQUEST_IN6     : integer := 0;
			USE_RESET_REQUEST_IN7     : integer := 0;
			USE_RESET_REQUEST_IN8     : integer := 0;
			USE_RESET_REQUEST_IN9     : integer := 0;
			USE_RESET_REQUEST_IN10    : integer := 0;
			USE_RESET_REQUEST_IN11    : integer := 0;
			USE_RESET_REQUEST_IN12    : integer := 0;
			USE_RESET_REQUEST_IN13    : integer := 0;
			USE_RESET_REQUEST_IN14    : integer := 0;
			USE_RESET_REQUEST_IN15    : integer := 0;
			ADAPT_RESET_REQUEST       : integer := 0
		);
		port (
			reset_in0      : in  std_logic := 'X'; -- reset_in0.reset
			reset_in1      : in  std_logic := 'X'; -- reset_in1.reset
			clk            : in  std_logic := 'X'; --       clk.clk
			reset_out      : out std_logic;        -- reset_out.reset
			reset_in10     : in  std_logic := 'X';
			reset_in11     : in  std_logic := 'X';
			reset_in12     : in  std_logic := 'X';
			reset_in13     : in  std_logic := 'X';
			reset_in14     : in  std_logic := 'X';
			reset_in15     : in  std_logic := 'X';
			reset_in2      : in  std_logic := 'X';
			reset_in3      : in  std_logic := 'X';
			reset_in4      : in  std_logic := 'X';
			reset_in5      : in  std_logic := 'X';
			reset_in6      : in  std_logic := 'X';
			reset_in7      : in  std_logic := 'X';
			reset_in8      : in  std_logic := 'X';
			reset_in9      : in  std_logic := 'X';
			reset_req      : out std_logic;
			reset_req_in0  : in  std_logic := 'X';
			reset_req_in1  : in  std_logic := 'X';
			reset_req_in10 : in  std_logic := 'X';
			reset_req_in11 : in  std_logic := 'X';
			reset_req_in12 : in  std_logic := 'X';
			reset_req_in13 : in  std_logic := 'X';
			reset_req_in14 : in  std_logic := 'X';
			reset_req_in15 : in  std_logic := 'X';
			reset_req_in2  : in  std_logic := 'X';
			reset_req_in3  : in  std_logic := 'X';
			reset_req_in4  : in  std_logic := 'X';
			reset_req_in5  : in  std_logic := 'X';
			reset_req_in6  : in  std_logic := 'X';
			reset_req_in7  : in  std_logic := 'X';
			reset_req_in8  : in  std_logic := 'X';
			reset_req_in9  : in  std_logic := 'X'
		);
	end component nios_system_2a_rst_controller_003;

	signal video_character_buffer_with_dma_0_avalon_char_source_valid                               : std_logic;                     -- video_character_buffer_with_dma_0:stream_valid -> video_dual_clock_buffer_0:stream_in_valid
	signal video_character_buffer_with_dma_0_avalon_char_source_data                                : std_logic_vector(29 downto 0); -- video_character_buffer_with_dma_0:stream_data -> video_dual_clock_buffer_0:stream_in_data
	signal video_character_buffer_with_dma_0_avalon_char_source_ready                               : std_logic;                     -- video_dual_clock_buffer_0:stream_in_ready -> video_character_buffer_with_dma_0:stream_ready
	signal video_character_buffer_with_dma_0_avalon_char_source_startofpacket                       : std_logic;                     -- video_character_buffer_with_dma_0:stream_startofpacket -> video_dual_clock_buffer_0:stream_in_startofpacket
	signal video_character_buffer_with_dma_0_avalon_char_source_endofpacket                         : std_logic;                     -- video_character_buffer_with_dma_0:stream_endofpacket -> video_dual_clock_buffer_0:stream_in_endofpacket
	signal video_dual_clock_buffer_0_avalon_dc_buffer_source_valid                                  : std_logic;                     -- video_dual_clock_buffer_0:stream_out_valid -> video_vga_controller_0:valid
	signal video_dual_clock_buffer_0_avalon_dc_buffer_source_data                                   : std_logic_vector(29 downto 0); -- video_dual_clock_buffer_0:stream_out_data -> video_vga_controller_0:data
	signal video_dual_clock_buffer_0_avalon_dc_buffer_source_ready                                  : std_logic;                     -- video_vga_controller_0:ready -> video_dual_clock_buffer_0:stream_out_ready
	signal video_dual_clock_buffer_0_avalon_dc_buffer_source_startofpacket                          : std_logic;                     -- video_dual_clock_buffer_0:stream_out_startofpacket -> video_vga_controller_0:startofpacket
	signal video_dual_clock_buffer_0_avalon_dc_buffer_source_endofpacket                            : std_logic;                     -- video_dual_clock_buffer_0:stream_out_endofpacket -> video_vga_controller_0:endofpacket
	signal clocks_sys_clk_clk                                                                       : std_logic;                     -- clocks:sys_clk_clk -> [BUTTON_pio:clk, LED_pio:clk, avalon_noc_adapter_pd_0:clk, cpu:clk, high_res_timer:clk, irq_mapper:clk, jtag_uart:clk, mm_interconnect_0:clocks_sys_clk_clk, onchip_memory:clk, rst_controller:clk, rst_controller_001:clk, sdram:clk, video_character_buffer_with_dma_0:clk, video_dual_clock_buffer_0:clk_stream_in, video_pll_0:ref_clk_clk]
	signal video_pll_0_vga_clk_clk                                                                  : std_logic;                     -- video_pll_0:vga_clk_clk -> [rst_controller_002:clk, rst_controller_003:clk, video_dual_clock_buffer_0:clk_stream_out, video_vga_controller_0:clk]
	signal cpu_debug_reset_request_reset                                                            : std_logic;                     -- cpu:debug_reset_request -> [rst_controller:reset_in0, rst_controller_001:reset_in0, rst_controller_003:reset_in0, video_pll_0:ref_reset_reset]
	signal cpu_data_master_readdata                                                                 : std_logic_vector(31 downto 0); -- mm_interconnect_0:cpu_data_master_readdata -> cpu:d_readdata
	signal cpu_data_master_waitrequest                                                              : std_logic;                     -- mm_interconnect_0:cpu_data_master_waitrequest -> cpu:d_waitrequest
	signal cpu_data_master_debugaccess                                                              : std_logic;                     -- cpu:debug_mem_slave_debugaccess_to_roms -> mm_interconnect_0:cpu_data_master_debugaccess
	signal cpu_data_master_address                                                                  : std_logic_vector(27 downto 0); -- cpu:d_address -> mm_interconnect_0:cpu_data_master_address
	signal cpu_data_master_byteenable                                                               : std_logic_vector(3 downto 0);  -- cpu:d_byteenable -> mm_interconnect_0:cpu_data_master_byteenable
	signal cpu_data_master_read                                                                     : std_logic;                     -- cpu:d_read -> mm_interconnect_0:cpu_data_master_read
	signal cpu_data_master_write                                                                    : std_logic;                     -- cpu:d_write -> mm_interconnect_0:cpu_data_master_write
	signal cpu_data_master_writedata                                                                : std_logic_vector(31 downto 0); -- cpu:d_writedata -> mm_interconnect_0:cpu_data_master_writedata
	signal cpu_instruction_master_readdata                                                          : std_logic_vector(31 downto 0); -- mm_interconnect_0:cpu_instruction_master_readdata -> cpu:i_readdata
	signal cpu_instruction_master_waitrequest                                                       : std_logic;                     -- mm_interconnect_0:cpu_instruction_master_waitrequest -> cpu:i_waitrequest
	signal cpu_instruction_master_address                                                           : std_logic_vector(27 downto 0); -- cpu:i_address -> mm_interconnect_0:cpu_instruction_master_address
	signal cpu_instruction_master_read                                                              : std_logic;                     -- cpu:i_read -> mm_interconnect_0:cpu_instruction_master_read
	signal mm_interconnect_0_video_character_buffer_with_dma_0_avalon_char_buffer_slave_chipselect  : std_logic;                     -- mm_interconnect_0:video_character_buffer_with_dma_0_avalon_char_buffer_slave_chipselect -> video_character_buffer_with_dma_0:buf_chipselect
	signal mm_interconnect_0_video_character_buffer_with_dma_0_avalon_char_buffer_slave_readdata    : std_logic_vector(7 downto 0);  -- video_character_buffer_with_dma_0:buf_readdata -> mm_interconnect_0:video_character_buffer_with_dma_0_avalon_char_buffer_slave_readdata
	signal mm_interconnect_0_video_character_buffer_with_dma_0_avalon_char_buffer_slave_waitrequest : std_logic;                     -- video_character_buffer_with_dma_0:buf_waitrequest -> mm_interconnect_0:video_character_buffer_with_dma_0_avalon_char_buffer_slave_waitrequest
	signal mm_interconnect_0_video_character_buffer_with_dma_0_avalon_char_buffer_slave_address     : std_logic_vector(12 downto 0); -- mm_interconnect_0:video_character_buffer_with_dma_0_avalon_char_buffer_slave_address -> video_character_buffer_with_dma_0:buf_address
	signal mm_interconnect_0_video_character_buffer_with_dma_0_avalon_char_buffer_slave_read        : std_logic;                     -- mm_interconnect_0:video_character_buffer_with_dma_0_avalon_char_buffer_slave_read -> video_character_buffer_with_dma_0:buf_read
	signal mm_interconnect_0_video_character_buffer_with_dma_0_avalon_char_buffer_slave_byteenable  : std_logic_vector(0 downto 0);  -- mm_interconnect_0:video_character_buffer_with_dma_0_avalon_char_buffer_slave_byteenable -> video_character_buffer_with_dma_0:buf_byteenable
	signal mm_interconnect_0_video_character_buffer_with_dma_0_avalon_char_buffer_slave_write       : std_logic;                     -- mm_interconnect_0:video_character_buffer_with_dma_0_avalon_char_buffer_slave_write -> video_character_buffer_with_dma_0:buf_write
	signal mm_interconnect_0_video_character_buffer_with_dma_0_avalon_char_buffer_slave_writedata   : std_logic_vector(7 downto 0);  -- mm_interconnect_0:video_character_buffer_with_dma_0_avalon_char_buffer_slave_writedata -> video_character_buffer_with_dma_0:buf_writedata
	signal mm_interconnect_0_video_character_buffer_with_dma_0_avalon_char_control_slave_chipselect : std_logic;                     -- mm_interconnect_0:video_character_buffer_with_dma_0_avalon_char_control_slave_chipselect -> video_character_buffer_with_dma_0:ctrl_chipselect
	signal mm_interconnect_0_video_character_buffer_with_dma_0_avalon_char_control_slave_readdata   : std_logic_vector(31 downto 0); -- video_character_buffer_with_dma_0:ctrl_readdata -> mm_interconnect_0:video_character_buffer_with_dma_0_avalon_char_control_slave_readdata
	signal mm_interconnect_0_video_character_buffer_with_dma_0_avalon_char_control_slave_address    : std_logic_vector(0 downto 0);  -- mm_interconnect_0:video_character_buffer_with_dma_0_avalon_char_control_slave_address -> video_character_buffer_with_dma_0:ctrl_address
	signal mm_interconnect_0_video_character_buffer_with_dma_0_avalon_char_control_slave_read       : std_logic;                     -- mm_interconnect_0:video_character_buffer_with_dma_0_avalon_char_control_slave_read -> video_character_buffer_with_dma_0:ctrl_read
	signal mm_interconnect_0_video_character_buffer_with_dma_0_avalon_char_control_slave_byteenable : std_logic_vector(3 downto 0);  -- mm_interconnect_0:video_character_buffer_with_dma_0_avalon_char_control_slave_byteenable -> video_character_buffer_with_dma_0:ctrl_byteenable
	signal mm_interconnect_0_video_character_buffer_with_dma_0_avalon_char_control_slave_write      : std_logic;                     -- mm_interconnect_0:video_character_buffer_with_dma_0_avalon_char_control_slave_write -> video_character_buffer_with_dma_0:ctrl_write
	signal mm_interconnect_0_video_character_buffer_with_dma_0_avalon_char_control_slave_writedata  : std_logic_vector(31 downto 0); -- mm_interconnect_0:video_character_buffer_with_dma_0_avalon_char_control_slave_writedata -> video_character_buffer_with_dma_0:ctrl_writedata
	signal mm_interconnect_0_jtag_uart_avalon_jtag_slave_chipselect                                 : std_logic;                     -- mm_interconnect_0:jtag_uart_avalon_jtag_slave_chipselect -> jtag_uart:av_chipselect
	signal mm_interconnect_0_jtag_uart_avalon_jtag_slave_readdata                                   : std_logic_vector(31 downto 0); -- jtag_uart:av_readdata -> mm_interconnect_0:jtag_uart_avalon_jtag_slave_readdata
	signal mm_interconnect_0_jtag_uart_avalon_jtag_slave_waitrequest                                : std_logic;                     -- jtag_uart:av_waitrequest -> mm_interconnect_0:jtag_uart_avalon_jtag_slave_waitrequest
	signal mm_interconnect_0_jtag_uart_avalon_jtag_slave_address                                    : std_logic_vector(0 downto 0);  -- mm_interconnect_0:jtag_uart_avalon_jtag_slave_address -> jtag_uart:av_address
	signal mm_interconnect_0_jtag_uart_avalon_jtag_slave_read                                       : std_logic;                     -- mm_interconnect_0:jtag_uart_avalon_jtag_slave_read -> mm_interconnect_0_jtag_uart_avalon_jtag_slave_read:in
	signal mm_interconnect_0_jtag_uart_avalon_jtag_slave_write                                      : std_logic;                     -- mm_interconnect_0:jtag_uart_avalon_jtag_slave_write -> mm_interconnect_0_jtag_uart_avalon_jtag_slave_write:in
	signal mm_interconnect_0_jtag_uart_avalon_jtag_slave_writedata                                  : std_logic_vector(31 downto 0); -- mm_interconnect_0:jtag_uart_avalon_jtag_slave_writedata -> jtag_uart:av_writedata
	signal mm_interconnect_0_avalon_noc_adapter_pd_0_avs_readdata                                   : std_logic_vector(31 downto 0); -- avalon_noc_adapter_pd_0:avs_readdata -> mm_interconnect_0:avalon_noc_adapter_pd_0_avs_readdata
	signal mm_interconnect_0_avalon_noc_adapter_pd_0_avs_address                                    : std_logic_vector(2 downto 0);  -- mm_interconnect_0:avalon_noc_adapter_pd_0_avs_address -> avalon_noc_adapter_pd_0:avs_address
	signal mm_interconnect_0_avalon_noc_adapter_pd_0_avs_read                                       : std_logic;                     -- mm_interconnect_0:avalon_noc_adapter_pd_0_avs_read -> avalon_noc_adapter_pd_0:avs_read
	signal mm_interconnect_0_avalon_noc_adapter_pd_0_avs_write                                      : std_logic;                     -- mm_interconnect_0:avalon_noc_adapter_pd_0_avs_write -> avalon_noc_adapter_pd_0:avs_write
	signal mm_interconnect_0_avalon_noc_adapter_pd_0_avs_writedata                                  : std_logic_vector(31 downto 0); -- mm_interconnect_0:avalon_noc_adapter_pd_0_avs_writedata -> avalon_noc_adapter_pd_0:avs_writedata
	signal mm_interconnect_0_cpu_debug_mem_slave_readdata                                           : std_logic_vector(31 downto 0); -- cpu:debug_mem_slave_readdata -> mm_interconnect_0:cpu_debug_mem_slave_readdata
	signal mm_interconnect_0_cpu_debug_mem_slave_waitrequest                                        : std_logic;                     -- cpu:debug_mem_slave_waitrequest -> mm_interconnect_0:cpu_debug_mem_slave_waitrequest
	signal mm_interconnect_0_cpu_debug_mem_slave_debugaccess                                        : std_logic;                     -- mm_interconnect_0:cpu_debug_mem_slave_debugaccess -> cpu:debug_mem_slave_debugaccess
	signal mm_interconnect_0_cpu_debug_mem_slave_address                                            : std_logic_vector(8 downto 0);  -- mm_interconnect_0:cpu_debug_mem_slave_address -> cpu:debug_mem_slave_address
	signal mm_interconnect_0_cpu_debug_mem_slave_read                                               : std_logic;                     -- mm_interconnect_0:cpu_debug_mem_slave_read -> cpu:debug_mem_slave_read
	signal mm_interconnect_0_cpu_debug_mem_slave_byteenable                                         : std_logic_vector(3 downto 0);  -- mm_interconnect_0:cpu_debug_mem_slave_byteenable -> cpu:debug_mem_slave_byteenable
	signal mm_interconnect_0_cpu_debug_mem_slave_write                                              : std_logic;                     -- mm_interconnect_0:cpu_debug_mem_slave_write -> cpu:debug_mem_slave_write
	signal mm_interconnect_0_cpu_debug_mem_slave_writedata                                          : std_logic_vector(31 downto 0); -- mm_interconnect_0:cpu_debug_mem_slave_writedata -> cpu:debug_mem_slave_writedata
	signal mm_interconnect_0_onchip_memory_s1_chipselect                                            : std_logic;                     -- mm_interconnect_0:onchip_memory_s1_chipselect -> onchip_memory:chipselect
	signal mm_interconnect_0_onchip_memory_s1_readdata                                              : std_logic_vector(31 downto 0); -- onchip_memory:readdata -> mm_interconnect_0:onchip_memory_s1_readdata
	signal mm_interconnect_0_onchip_memory_s1_address                                               : std_logic_vector(12 downto 0); -- mm_interconnect_0:onchip_memory_s1_address -> onchip_memory:address
	signal mm_interconnect_0_onchip_memory_s1_byteenable                                            : std_logic_vector(3 downto 0);  -- mm_interconnect_0:onchip_memory_s1_byteenable -> onchip_memory:byteenable
	signal mm_interconnect_0_onchip_memory_s1_write                                                 : std_logic;                     -- mm_interconnect_0:onchip_memory_s1_write -> onchip_memory:write
	signal mm_interconnect_0_onchip_memory_s1_writedata                                             : std_logic_vector(31 downto 0); -- mm_interconnect_0:onchip_memory_s1_writedata -> onchip_memory:writedata
	signal mm_interconnect_0_onchip_memory_s1_clken                                                 : std_logic;                     -- mm_interconnect_0:onchip_memory_s1_clken -> onchip_memory:clken
	signal mm_interconnect_0_led_pio_s1_chipselect                                                  : std_logic;                     -- mm_interconnect_0:LED_pio_s1_chipselect -> LED_pio:chipselect
	signal mm_interconnect_0_led_pio_s1_readdata                                                    : std_logic_vector(31 downto 0); -- LED_pio:readdata -> mm_interconnect_0:LED_pio_s1_readdata
	signal mm_interconnect_0_led_pio_s1_address                                                     : std_logic_vector(1 downto 0);  -- mm_interconnect_0:LED_pio_s1_address -> LED_pio:address
	signal mm_interconnect_0_led_pio_s1_write                                                       : std_logic;                     -- mm_interconnect_0:LED_pio_s1_write -> mm_interconnect_0_led_pio_s1_write:in
	signal mm_interconnect_0_led_pio_s1_writedata                                                   : std_logic_vector(31 downto 0); -- mm_interconnect_0:LED_pio_s1_writedata -> LED_pio:writedata
	signal mm_interconnect_0_sdram_s1_chipselect                                                    : std_logic;                     -- mm_interconnect_0:sdram_s1_chipselect -> sdram:az_cs
	signal mm_interconnect_0_sdram_s1_readdata                                                      : std_logic_vector(15 downto 0); -- sdram:za_data -> mm_interconnect_0:sdram_s1_readdata
	signal mm_interconnect_0_sdram_s1_waitrequest                                                   : std_logic;                     -- sdram:za_waitrequest -> mm_interconnect_0:sdram_s1_waitrequest
	signal mm_interconnect_0_sdram_s1_address                                                       : std_logic_vector(24 downto 0); -- mm_interconnect_0:sdram_s1_address -> sdram:az_addr
	signal mm_interconnect_0_sdram_s1_read                                                          : std_logic;                     -- mm_interconnect_0:sdram_s1_read -> mm_interconnect_0_sdram_s1_read:in
	signal mm_interconnect_0_sdram_s1_byteenable                                                    : std_logic_vector(1 downto 0);  -- mm_interconnect_0:sdram_s1_byteenable -> mm_interconnect_0_sdram_s1_byteenable:in
	signal mm_interconnect_0_sdram_s1_readdatavalid                                                 : std_logic;                     -- sdram:za_valid -> mm_interconnect_0:sdram_s1_readdatavalid
	signal mm_interconnect_0_sdram_s1_write                                                         : std_logic;                     -- mm_interconnect_0:sdram_s1_write -> mm_interconnect_0_sdram_s1_write:in
	signal mm_interconnect_0_sdram_s1_writedata                                                     : std_logic_vector(15 downto 0); -- mm_interconnect_0:sdram_s1_writedata -> sdram:az_data
	signal mm_interconnect_0_high_res_timer_s1_chipselect                                           : std_logic;                     -- mm_interconnect_0:high_res_timer_s1_chipselect -> high_res_timer:chipselect
	signal mm_interconnect_0_high_res_timer_s1_readdata                                             : std_logic_vector(15 downto 0); -- high_res_timer:readdata -> mm_interconnect_0:high_res_timer_s1_readdata
	signal mm_interconnect_0_high_res_timer_s1_address                                              : std_logic_vector(2 downto 0);  -- mm_interconnect_0:high_res_timer_s1_address -> high_res_timer:address
	signal mm_interconnect_0_high_res_timer_s1_write                                                : std_logic;                     -- mm_interconnect_0:high_res_timer_s1_write -> mm_interconnect_0_high_res_timer_s1_write:in
	signal mm_interconnect_0_high_res_timer_s1_writedata                                            : std_logic_vector(15 downto 0); -- mm_interconnect_0:high_res_timer_s1_writedata -> high_res_timer:writedata
	signal mm_interconnect_0_button_pio_s1_chipselect                                               : std_logic;                     -- mm_interconnect_0:BUTTON_pio_s1_chipselect -> BUTTON_pio:chipselect
	signal mm_interconnect_0_button_pio_s1_readdata                                                 : std_logic_vector(31 downto 0); -- BUTTON_pio:readdata -> mm_interconnect_0:BUTTON_pio_s1_readdata
	signal mm_interconnect_0_button_pio_s1_address                                                  : std_logic_vector(1 downto 0);  -- mm_interconnect_0:BUTTON_pio_s1_address -> BUTTON_pio:address
	signal mm_interconnect_0_button_pio_s1_write                                                    : std_logic;                     -- mm_interconnect_0:BUTTON_pio_s1_write -> mm_interconnect_0_button_pio_s1_write:in
	signal mm_interconnect_0_button_pio_s1_writedata                                                : std_logic_vector(31 downto 0); -- mm_interconnect_0:BUTTON_pio_s1_writedata -> BUTTON_pio:writedata
	signal irq_mapper_receiver0_irq                                                                 : std_logic;                     -- jtag_uart:av_irq -> irq_mapper:receiver0_irq
	signal irq_mapper_receiver1_irq                                                                 : std_logic;                     -- high_res_timer:irq -> irq_mapper:receiver1_irq
	signal irq_mapper_receiver2_irq                                                                 : std_logic;                     -- BUTTON_pio:irq -> irq_mapper:receiver2_irq
	signal irq_mapper_receiver3_irq                                                                 : std_logic;                     -- avalon_noc_adapter_pd_0:irq -> irq_mapper:receiver3_irq
	signal cpu_irq_irq                                                                              : std_logic_vector(31 downto 0); -- irq_mapper:sender_irq -> cpu:irq
	signal rst_controller_reset_out_reset                                                           : std_logic;                     -- rst_controller:reset_out -> [irq_mapper:reset, mm_interconnect_0:avalon_noc_adapter_pd_0_reset_reset_bridge_in_reset_reset, mm_interconnect_0:cpu_reset_reset_bridge_in_reset_reset, onchip_memory:reset, rst_controller_reset_out_reset:in, rst_translator:in_reset, video_character_buffer_with_dma_0:reset, video_dual_clock_buffer_0:reset_stream_in]
	signal rst_controller_reset_out_reset_req                                                       : std_logic;                     -- rst_controller:reset_req -> [cpu:reset_req, onchip_memory:reset_req, rst_translator:reset_req_in]
	signal rst_controller_001_reset_out_reset                                                       : std_logic;                     -- rst_controller_001:reset_out -> avalon_noc_adapter_pd_0:reset
	signal rst_controller_002_reset_out_reset                                                       : std_logic;                     -- rst_controller_002:reset_out -> video_dual_clock_buffer_0:reset_stream_out
	signal video_pll_0_reset_source_reset                                                           : std_logic;                     -- video_pll_0:reset_source_reset -> [rst_controller_002:reset_in0, rst_controller_003:reset_in1]
	signal rst_controller_003_reset_out_reset                                                       : std_logic;                     -- rst_controller_003:reset_out -> video_vga_controller_0:reset
	signal mm_interconnect_0_jtag_uart_avalon_jtag_slave_read_ports_inv                             : std_logic;                     -- mm_interconnect_0_jtag_uart_avalon_jtag_slave_read:inv -> jtag_uart:av_read_n
	signal mm_interconnect_0_jtag_uart_avalon_jtag_slave_write_ports_inv                            : std_logic;                     -- mm_interconnect_0_jtag_uart_avalon_jtag_slave_write:inv -> jtag_uart:av_write_n
	signal mm_interconnect_0_led_pio_s1_write_ports_inv                                             : std_logic;                     -- mm_interconnect_0_led_pio_s1_write:inv -> LED_pio:write_n
	signal mm_interconnect_0_sdram_s1_read_ports_inv                                                : std_logic;                     -- mm_interconnect_0_sdram_s1_read:inv -> sdram:az_rd_n
	signal mm_interconnect_0_sdram_s1_byteenable_ports_inv                                          : std_logic_vector(1 downto 0);  -- mm_interconnect_0_sdram_s1_byteenable:inv -> sdram:az_be_n
	signal mm_interconnect_0_sdram_s1_write_ports_inv                                               : std_logic;                     -- mm_interconnect_0_sdram_s1_write:inv -> sdram:az_wr_n
	signal mm_interconnect_0_high_res_timer_s1_write_ports_inv                                      : std_logic;                     -- mm_interconnect_0_high_res_timer_s1_write:inv -> high_res_timer:write_n
	signal mm_interconnect_0_button_pio_s1_write_ports_inv                                          : std_logic;                     -- mm_interconnect_0_button_pio_s1_write:inv -> BUTTON_pio:write_n
	signal rst_controller_reset_out_reset_ports_inv                                                 : std_logic;                     -- rst_controller_reset_out_reset:inv -> [BUTTON_pio:reset_n, LED_pio:reset_n, cpu:reset_n, high_res_timer:reset_n, jtag_uart:rst_n, sdram:reset_n]

begin

	clocks_sys_clk_export <= clocks_sys_clk_clk;

	button_pio : component Nios_System_2A_BUTTON_pio
		port map (
			clk        => clocks_sys_clk_clk,                              --                 clk.clk
			reset_n    => rst_controller_reset_out_reset_ports_inv,        --               reset.reset_n
			address    => mm_interconnect_0_button_pio_s1_address,         --                  s1.address
			write_n    => mm_interconnect_0_button_pio_s1_write_ports_inv, --                    .write_n
			writedata  => mm_interconnect_0_button_pio_s1_writedata,       --                    .writedata
			chipselect => mm_interconnect_0_button_pio_s1_chipselect,      --                    .chipselect
			readdata   => mm_interconnect_0_button_pio_s1_readdata,        --                    .readdata
			in_port    => button_pio_external_connection_export,           -- external_connection.export
			irq        => irq_mapper_receiver2_irq                         --                 irq.irq
		);

	led_pio : component Nios_System_2A_LED_pio
		port map (
			clk        => clocks_sys_clk_clk,                           --                 clk.clk
			reset_n    => rst_controller_reset_out_reset_ports_inv,     --               reset.reset_n
			address    => mm_interconnect_0_led_pio_s1_address,         --                  s1.address
			write_n    => mm_interconnect_0_led_pio_s1_write_ports_inv, --                    .write_n
			writedata  => mm_interconnect_0_led_pio_s1_writedata,       --                    .writedata
			chipselect => mm_interconnect_0_led_pio_s1_chipselect,      --                    .chipselect
			readdata   => mm_interconnect_0_led_pio_s1_readdata,        --                    .readdata
			out_port   => led_pio_external_connection_export            -- external_connection.export
		);

	avalon_noc_adapter_pd_0 : component avalon_noc_adapter_pd
		port map (
			clk           => clocks_sys_clk_clk,                                      --    clock.clk
			reset         => rst_controller_001_reset_out_reset,                      --    reset.reset
			avs_address   => mm_interconnect_0_avalon_noc_adapter_pd_0_avs_address,   --      avs.address
			avs_read      => mm_interconnect_0_avalon_noc_adapter_pd_0_avs_read,      --         .read
			avs_write     => mm_interconnect_0_avalon_noc_adapter_pd_0_avs_write,     --         .write
			avs_writedata => mm_interconnect_0_avalon_noc_adapter_pd_0_avs_writedata, --         .writedata
			avs_readdata  => mm_interconnect_0_avalon_noc_adapter_pd_0_avs_readdata,  --         .readdata
			irq           => irq_mapper_receiver3_irq,                                --      irq.irq
			noc_send_addr => noc_send_addr,                                           -- noc_send.addr
			noc_send_data => noc_send_data,                                           --         .data
			noc_recv_addr => noc_recv_addr,                                           -- noc_recv.addr
			noc_recv_data => noc_recv_data                                            --         .data
		);

	clocks : component Nios_System_2A_clocks
		port map (
			ref_clk_clk        => clocks_ref_clk_clk,     --      ref_clk.clk
			ref_reset_reset    => clocks_ref_reset_reset, --    ref_reset.reset
			sys_clk_clk        => clocks_sys_clk_clk,     --      sys_clk.clk
			sdram_clk_clk      => clocks_sdram_clk_clk,   --    sdram_clk.clk
			reset_source_reset => open                    -- reset_source.reset
		);

	cpu : component Nios_System_2A_cpu
		port map (
			clk                                 => clocks_sys_clk_clk,                                --                       clk.clk
			reset_n                             => rst_controller_reset_out_reset_ports_inv,          --                     reset.reset_n
			reset_req                           => rst_controller_reset_out_reset_req,                --                          .reset_req
			d_address                           => cpu_data_master_address,                           --               data_master.address
			d_byteenable                        => cpu_data_master_byteenable,                        --                          .byteenable
			d_read                              => cpu_data_master_read,                              --                          .read
			d_readdata                          => cpu_data_master_readdata,                          --                          .readdata
			d_waitrequest                       => cpu_data_master_waitrequest,                       --                          .waitrequest
			d_write                             => cpu_data_master_write,                             --                          .write
			d_writedata                         => cpu_data_master_writedata,                         --                          .writedata
			debug_mem_slave_debugaccess_to_roms => cpu_data_master_debugaccess,                       --                          .debugaccess
			i_address                           => cpu_instruction_master_address,                    --        instruction_master.address
			i_read                              => cpu_instruction_master_read,                       --                          .read
			i_readdata                          => cpu_instruction_master_readdata,                   --                          .readdata
			i_waitrequest                       => cpu_instruction_master_waitrequest,                --                          .waitrequest
			irq                                 => cpu_irq_irq,                                       --                       irq.irq
			debug_reset_request                 => cpu_debug_reset_request_reset,                     --       debug_reset_request.reset
			debug_mem_slave_address             => mm_interconnect_0_cpu_debug_mem_slave_address,     --           debug_mem_slave.address
			debug_mem_slave_byteenable          => mm_interconnect_0_cpu_debug_mem_slave_byteenable,  --                          .byteenable
			debug_mem_slave_debugaccess         => mm_interconnect_0_cpu_debug_mem_slave_debugaccess, --                          .debugaccess
			debug_mem_slave_read                => mm_interconnect_0_cpu_debug_mem_slave_read,        --                          .read
			debug_mem_slave_readdata            => mm_interconnect_0_cpu_debug_mem_slave_readdata,    --                          .readdata
			debug_mem_slave_waitrequest         => mm_interconnect_0_cpu_debug_mem_slave_waitrequest, --                          .waitrequest
			debug_mem_slave_write               => mm_interconnect_0_cpu_debug_mem_slave_write,       --                          .write
			debug_mem_slave_writedata           => mm_interconnect_0_cpu_debug_mem_slave_writedata,   --                          .writedata
			dummy_ci_port                       => open                                               -- custom_instruction_master.readra
		);

	high_res_timer : component Nios_System_2A_high_res_timer
		port map (
			clk        => clocks_sys_clk_clk,                                  --   clk.clk
			reset_n    => rst_controller_reset_out_reset_ports_inv,            -- reset.reset_n
			address    => mm_interconnect_0_high_res_timer_s1_address,         --    s1.address
			writedata  => mm_interconnect_0_high_res_timer_s1_writedata,       --      .writedata
			readdata   => mm_interconnect_0_high_res_timer_s1_readdata,        --      .readdata
			chipselect => mm_interconnect_0_high_res_timer_s1_chipselect,      --      .chipselect
			write_n    => mm_interconnect_0_high_res_timer_s1_write_ports_inv, --      .write_n
			irq        => irq_mapper_receiver1_irq                             --   irq.irq
		);

	jtag_uart : component Nios_System_2A_jtag_uart
		port map (
			clk            => clocks_sys_clk_clk,                                            --               clk.clk
			rst_n          => rst_controller_reset_out_reset_ports_inv,                      --             reset.reset_n
			av_chipselect  => mm_interconnect_0_jtag_uart_avalon_jtag_slave_chipselect,      -- avalon_jtag_slave.chipselect
			av_address     => mm_interconnect_0_jtag_uart_avalon_jtag_slave_address(0),      --                  .address
			av_read_n      => mm_interconnect_0_jtag_uart_avalon_jtag_slave_read_ports_inv,  --                  .read_n
			av_readdata    => mm_interconnect_0_jtag_uart_avalon_jtag_slave_readdata,        --                  .readdata
			av_write_n     => mm_interconnect_0_jtag_uart_avalon_jtag_slave_write_ports_inv, --                  .write_n
			av_writedata   => mm_interconnect_0_jtag_uart_avalon_jtag_slave_writedata,       --                  .writedata
			av_waitrequest => mm_interconnect_0_jtag_uart_avalon_jtag_slave_waitrequest,     --                  .waitrequest
			av_irq         => irq_mapper_receiver0_irq                                       --               irq.irq
		);

	onchip_memory : component Nios_System_2A_onchip_memory
		port map (
			clk        => clocks_sys_clk_clk,                            --   clk1.clk
			address    => mm_interconnect_0_onchip_memory_s1_address,    --     s1.address
			clken      => mm_interconnect_0_onchip_memory_s1_clken,      --       .clken
			chipselect => mm_interconnect_0_onchip_memory_s1_chipselect, --       .chipselect
			write      => mm_interconnect_0_onchip_memory_s1_write,      --       .write
			readdata   => mm_interconnect_0_onchip_memory_s1_readdata,   --       .readdata
			writedata  => mm_interconnect_0_onchip_memory_s1_writedata,  --       .writedata
			byteenable => mm_interconnect_0_onchip_memory_s1_byteenable, --       .byteenable
			reset      => rst_controller_reset_out_reset,                -- reset1.reset
			reset_req  => rst_controller_reset_out_reset_req,            --       .reset_req
			freeze     => '0'                                            -- (terminated)
		);

	sdram : component Nios_System_2A_sdram
		port map (
			clk            => clocks_sys_clk_clk,                              --   clk.clk
			reset_n        => rst_controller_reset_out_reset_ports_inv,        -- reset.reset_n
			az_addr        => mm_interconnect_0_sdram_s1_address,              --    s1.address
			az_be_n        => mm_interconnect_0_sdram_s1_byteenable_ports_inv, --      .byteenable_n
			az_cs          => mm_interconnect_0_sdram_s1_chipselect,           --      .chipselect
			az_data        => mm_interconnect_0_sdram_s1_writedata,            --      .writedata
			az_rd_n        => mm_interconnect_0_sdram_s1_read_ports_inv,       --      .read_n
			az_wr_n        => mm_interconnect_0_sdram_s1_write_ports_inv,      --      .write_n
			za_data        => mm_interconnect_0_sdram_s1_readdata,             --      .readdata
			za_valid       => mm_interconnect_0_sdram_s1_readdatavalid,        --      .readdatavalid
			za_waitrequest => mm_interconnect_0_sdram_s1_waitrequest,          --      .waitrequest
			zs_addr        => sdram_wire_addr,                                 --  wire.export
			zs_ba          => sdram_wire_ba,                                   --      .export
			zs_cas_n       => sdram_wire_cas_n,                                --      .export
			zs_cke         => sdram_wire_cke,                                  --      .export
			zs_cs_n        => sdram_wire_cs_n,                                 --      .export
			zs_dq          => sdram_wire_dq,                                   --      .export
			zs_dqm         => sdram_wire_dqm,                                  --      .export
			zs_ras_n       => sdram_wire_ras_n,                                --      .export
			zs_we_n        => sdram_wire_we_n                                  --      .export
		);

	video_character_buffer_with_dma_0 : component Nios_System_2A_video_character_buffer_with_dma_0
		port map (
			clk                  => clocks_sys_clk_clk,                                                                         --                       clk.clk
			reset                => rst_controller_reset_out_reset,                                                             --                     reset.reset
			ctrl_address         => mm_interconnect_0_video_character_buffer_with_dma_0_avalon_char_control_slave_address(0),   -- avalon_char_control_slave.address
			ctrl_byteenable      => mm_interconnect_0_video_character_buffer_with_dma_0_avalon_char_control_slave_byteenable,   --                          .byteenable
			ctrl_chipselect      => mm_interconnect_0_video_character_buffer_with_dma_0_avalon_char_control_slave_chipselect,   --                          .chipselect
			ctrl_read            => mm_interconnect_0_video_character_buffer_with_dma_0_avalon_char_control_slave_read,         --                          .read
			ctrl_write           => mm_interconnect_0_video_character_buffer_with_dma_0_avalon_char_control_slave_write,        --                          .write
			ctrl_writedata       => mm_interconnect_0_video_character_buffer_with_dma_0_avalon_char_control_slave_writedata,    --                          .writedata
			ctrl_readdata        => mm_interconnect_0_video_character_buffer_with_dma_0_avalon_char_control_slave_readdata,     --                          .readdata
			buf_byteenable       => mm_interconnect_0_video_character_buffer_with_dma_0_avalon_char_buffer_slave_byteenable(0), --  avalon_char_buffer_slave.byteenable
			buf_chipselect       => mm_interconnect_0_video_character_buffer_with_dma_0_avalon_char_buffer_slave_chipselect,    --                          .chipselect
			buf_read             => mm_interconnect_0_video_character_buffer_with_dma_0_avalon_char_buffer_slave_read,          --                          .read
			buf_write            => mm_interconnect_0_video_character_buffer_with_dma_0_avalon_char_buffer_slave_write,         --                          .write
			buf_writedata        => mm_interconnect_0_video_character_buffer_with_dma_0_avalon_char_buffer_slave_writedata,     --                          .writedata
			buf_readdata         => mm_interconnect_0_video_character_buffer_with_dma_0_avalon_char_buffer_slave_readdata,      --                          .readdata
			buf_waitrequest      => mm_interconnect_0_video_character_buffer_with_dma_0_avalon_char_buffer_slave_waitrequest,   --                          .waitrequest
			buf_address          => mm_interconnect_0_video_character_buffer_with_dma_0_avalon_char_buffer_slave_address,       --                          .address
			stream_ready         => video_character_buffer_with_dma_0_avalon_char_source_ready,                                 --        avalon_char_source.ready
			stream_startofpacket => video_character_buffer_with_dma_0_avalon_char_source_startofpacket,                         --                          .startofpacket
			stream_endofpacket   => video_character_buffer_with_dma_0_avalon_char_source_endofpacket,                           --                          .endofpacket
			stream_valid         => video_character_buffer_with_dma_0_avalon_char_source_valid,                                 --                          .valid
			stream_data          => video_character_buffer_with_dma_0_avalon_char_source_data                                   --                          .data
		);

	video_dual_clock_buffer_0 : component Nios_System_2A_video_dual_clock_buffer_0
		port map (
			clk_stream_in            => clocks_sys_clk_clk,                                                 --         clock_stream_in.clk
			reset_stream_in          => rst_controller_reset_out_reset,                                     --         reset_stream_in.reset
			clk_stream_out           => video_pll_0_vga_clk_clk,                                            --        clock_stream_out.clk
			reset_stream_out         => rst_controller_002_reset_out_reset,                                 --        reset_stream_out.reset
			stream_in_ready          => video_character_buffer_with_dma_0_avalon_char_source_ready,         --   avalon_dc_buffer_sink.ready
			stream_in_startofpacket  => video_character_buffer_with_dma_0_avalon_char_source_startofpacket, --                        .startofpacket
			stream_in_endofpacket    => video_character_buffer_with_dma_0_avalon_char_source_endofpacket,   --                        .endofpacket
			stream_in_valid          => video_character_buffer_with_dma_0_avalon_char_source_valid,         --                        .valid
			stream_in_data           => video_character_buffer_with_dma_0_avalon_char_source_data,          --                        .data
			stream_out_ready         => video_dual_clock_buffer_0_avalon_dc_buffer_source_ready,            -- avalon_dc_buffer_source.ready
			stream_out_startofpacket => video_dual_clock_buffer_0_avalon_dc_buffer_source_startofpacket,    --                        .startofpacket
			stream_out_endofpacket   => video_dual_clock_buffer_0_avalon_dc_buffer_source_endofpacket,      --                        .endofpacket
			stream_out_valid         => video_dual_clock_buffer_0_avalon_dc_buffer_source_valid,            --                        .valid
			stream_out_data          => video_dual_clock_buffer_0_avalon_dc_buffer_source_data              --                        .data
		);

	video_pll_0 : component Nios_System_2A_video_pll_0
		port map (
			ref_clk_clk        => clocks_sys_clk_clk,             --      ref_clk.clk
			ref_reset_reset    => cpu_debug_reset_request_reset,  --    ref_reset.reset
			vga_clk_clk        => video_pll_0_vga_clk_clk,        --      vga_clk.clk
			reset_source_reset => video_pll_0_reset_source_reset  -- reset_source.reset
		);

	video_vga_controller_0 : component Nios_System_2A_video_vga_controller_0
		port map (
			clk           => video_pll_0_vga_clk_clk,                                         --                clk.clk
			reset         => rst_controller_003_reset_out_reset,                              --              reset.reset
			data          => video_dual_clock_buffer_0_avalon_dc_buffer_source_data,          --    avalon_vga_sink.data
			startofpacket => video_dual_clock_buffer_0_avalon_dc_buffer_source_startofpacket, --                   .startofpacket
			endofpacket   => video_dual_clock_buffer_0_avalon_dc_buffer_source_endofpacket,   --                   .endofpacket
			valid         => video_dual_clock_buffer_0_avalon_dc_buffer_source_valid,         --                   .valid
			ready         => video_dual_clock_buffer_0_avalon_dc_buffer_source_ready,         --                   .ready
			VGA_CLK       => video_vga_controller_0_external_interface_CLK,                   -- external_interface.export
			VGA_HS        => video_vga_controller_0_external_interface_HS,                    --                   .export
			VGA_VS        => video_vga_controller_0_external_interface_VS,                    --                   .export
			VGA_BLANK     => video_vga_controller_0_external_interface_BLANK,                 --                   .export
			VGA_SYNC      => video_vga_controller_0_external_interface_SYNC,                  --                   .export
			VGA_R         => video_vga_controller_0_external_interface_R,                     --                   .export
			VGA_G         => video_vga_controller_0_external_interface_G,                     --                   .export
			VGA_B         => video_vga_controller_0_external_interface_B                      --                   .export
		);

	mm_interconnect_0 : component Nios_System_2A_mm_interconnect_0
		port map (
			clocks_sys_clk_clk                                                     => clocks_sys_clk_clk,                                                                       --                                              clocks_sys_clk.clk
			avalon_noc_adapter_pd_0_reset_reset_bridge_in_reset_reset              => rst_controller_reset_out_reset,                                                           --         avalon_noc_adapter_pd_0_reset_reset_bridge_in_reset.reset
			cpu_reset_reset_bridge_in_reset_reset                                  => rst_controller_reset_out_reset,                                                           --                             cpu_reset_reset_bridge_in_reset.reset
			cpu_data_master_address                                                => cpu_data_master_address,                                                                  --                                             cpu_data_master.address
			cpu_data_master_waitrequest                                            => cpu_data_master_waitrequest,                                                              --                                                            .waitrequest
			cpu_data_master_byteenable                                             => cpu_data_master_byteenable,                                                               --                                                            .byteenable
			cpu_data_master_read                                                   => cpu_data_master_read,                                                                     --                                                            .read
			cpu_data_master_readdata                                               => cpu_data_master_readdata,                                                                 --                                                            .readdata
			cpu_data_master_write                                                  => cpu_data_master_write,                                                                    --                                                            .write
			cpu_data_master_writedata                                              => cpu_data_master_writedata,                                                                --                                                            .writedata
			cpu_data_master_debugaccess                                            => cpu_data_master_debugaccess,                                                              --                                                            .debugaccess
			cpu_instruction_master_address                                         => cpu_instruction_master_address,                                                           --                                      cpu_instruction_master.address
			cpu_instruction_master_waitrequest                                     => cpu_instruction_master_waitrequest,                                                       --                                                            .waitrequest
			cpu_instruction_master_read                                            => cpu_instruction_master_read,                                                              --                                                            .read
			cpu_instruction_master_readdata                                        => cpu_instruction_master_readdata,                                                          --                                                            .readdata
			avalon_noc_adapter_pd_0_avs_address                                    => mm_interconnect_0_avalon_noc_adapter_pd_0_avs_address,                                    --                                 avalon_noc_adapter_pd_0_avs.address
			avalon_noc_adapter_pd_0_avs_write                                      => mm_interconnect_0_avalon_noc_adapter_pd_0_avs_write,                                      --                                                            .write
			avalon_noc_adapter_pd_0_avs_read                                       => mm_interconnect_0_avalon_noc_adapter_pd_0_avs_read,                                       --                                                            .read
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
			video_character_buffer_with_dma_0_avalon_char_buffer_slave_byteenable  => mm_interconnect_0_video_character_buffer_with_dma_0_avalon_char_buffer_slave_byteenable,  --                                                            .byteenable
			video_character_buffer_with_dma_0_avalon_char_buffer_slave_waitrequest => mm_interconnect_0_video_character_buffer_with_dma_0_avalon_char_buffer_slave_waitrequest, --                                                            .waitrequest
			video_character_buffer_with_dma_0_avalon_char_buffer_slave_chipselect  => mm_interconnect_0_video_character_buffer_with_dma_0_avalon_char_buffer_slave_chipselect,  --                                                            .chipselect
			video_character_buffer_with_dma_0_avalon_char_control_slave_address    => mm_interconnect_0_video_character_buffer_with_dma_0_avalon_char_control_slave_address,    -- video_character_buffer_with_dma_0_avalon_char_control_slave.address
			video_character_buffer_with_dma_0_avalon_char_control_slave_write      => mm_interconnect_0_video_character_buffer_with_dma_0_avalon_char_control_slave_write,      --                                                            .write
			video_character_buffer_with_dma_0_avalon_char_control_slave_read       => mm_interconnect_0_video_character_buffer_with_dma_0_avalon_char_control_slave_read,       --                                                            .read
			video_character_buffer_with_dma_0_avalon_char_control_slave_readdata   => mm_interconnect_0_video_character_buffer_with_dma_0_avalon_char_control_slave_readdata,   --                                                            .readdata
			video_character_buffer_with_dma_0_avalon_char_control_slave_writedata  => mm_interconnect_0_video_character_buffer_with_dma_0_avalon_char_control_slave_writedata,  --                                                            .writedata
			video_character_buffer_with_dma_0_avalon_char_control_slave_byteenable => mm_interconnect_0_video_character_buffer_with_dma_0_avalon_char_control_slave_byteenable, --                                                            .byteenable
			video_character_buffer_with_dma_0_avalon_char_control_slave_chipselect => mm_interconnect_0_video_character_buffer_with_dma_0_avalon_char_control_slave_chipselect  --                                                            .chipselect
		);

	irq_mapper : component Nios_System_2A_irq_mapper
		port map (
			clk           => clocks_sys_clk_clk,             --       clk.clk
			reset         => rst_controller_reset_out_reset, -- clk_reset.reset
			receiver0_irq => irq_mapper_receiver0_irq,       -- receiver0.irq
			receiver1_irq => irq_mapper_receiver1_irq,       -- receiver1.irq
			receiver2_irq => irq_mapper_receiver2_irq,       -- receiver2.irq
			receiver3_irq => irq_mapper_receiver3_irq,       -- receiver3.irq
			sender_irq    => cpu_irq_irq                     --    sender.irq
		);

	rst_controller : component nios_system_2a_rst_controller
		generic map (
			NUM_RESET_INPUTS          => 1,
			OUTPUT_RESET_SYNC_EDGES   => "deassert",
			SYNC_DEPTH                => 2,
			RESET_REQUEST_PRESENT     => 1,
			RESET_REQ_WAIT_TIME       => 1,
			MIN_RST_ASSERTION_TIME    => 3,
			RESET_REQ_EARLY_DSRT_TIME => 1,
			USE_RESET_REQUEST_IN0     => 0,
			USE_RESET_REQUEST_IN1     => 0,
			USE_RESET_REQUEST_IN2     => 0,
			USE_RESET_REQUEST_IN3     => 0,
			USE_RESET_REQUEST_IN4     => 0,
			USE_RESET_REQUEST_IN5     => 0,
			USE_RESET_REQUEST_IN6     => 0,
			USE_RESET_REQUEST_IN7     => 0,
			USE_RESET_REQUEST_IN8     => 0,
			USE_RESET_REQUEST_IN9     => 0,
			USE_RESET_REQUEST_IN10    => 0,
			USE_RESET_REQUEST_IN11    => 0,
			USE_RESET_REQUEST_IN12    => 0,
			USE_RESET_REQUEST_IN13    => 0,
			USE_RESET_REQUEST_IN14    => 0,
			USE_RESET_REQUEST_IN15    => 0,
			ADAPT_RESET_REQUEST       => 0
		)
		port map (
			reset_in0      => cpu_debug_reset_request_reset,      -- reset_in0.reset
			clk            => clocks_sys_clk_clk,                 --       clk.clk
			reset_out      => rst_controller_reset_out_reset,     -- reset_out.reset
			reset_req      => rst_controller_reset_out_reset_req, --          .reset_req
			reset_req_in0  => '0',                                -- (terminated)
			reset_in1      => '0',                                -- (terminated)
			reset_req_in1  => '0',                                -- (terminated)
			reset_in2      => '0',                                -- (terminated)
			reset_req_in2  => '0',                                -- (terminated)
			reset_in3      => '0',                                -- (terminated)
			reset_req_in3  => '0',                                -- (terminated)
			reset_in4      => '0',                                -- (terminated)
			reset_req_in4  => '0',                                -- (terminated)
			reset_in5      => '0',                                -- (terminated)
			reset_req_in5  => '0',                                -- (terminated)
			reset_in6      => '0',                                -- (terminated)
			reset_req_in6  => '0',                                -- (terminated)
			reset_in7      => '0',                                -- (terminated)
			reset_req_in7  => '0',                                -- (terminated)
			reset_in8      => '0',                                -- (terminated)
			reset_req_in8  => '0',                                -- (terminated)
			reset_in9      => '0',                                -- (terminated)
			reset_req_in9  => '0',                                -- (terminated)
			reset_in10     => '0',                                -- (terminated)
			reset_req_in10 => '0',                                -- (terminated)
			reset_in11     => '0',                                -- (terminated)
			reset_req_in11 => '0',                                -- (terminated)
			reset_in12     => '0',                                -- (terminated)
			reset_req_in12 => '0',                                -- (terminated)
			reset_in13     => '0',                                -- (terminated)
			reset_req_in13 => '0',                                -- (terminated)
			reset_in14     => '0',                                -- (terminated)
			reset_req_in14 => '0',                                -- (terminated)
			reset_in15     => '0',                                -- (terminated)
			reset_req_in15 => '0'                                 -- (terminated)
		);

	rst_controller_001 : component nios_system_2a_rst_controller_001
		generic map (
			NUM_RESET_INPUTS          => 1,
			OUTPUT_RESET_SYNC_EDGES   => "both",
			SYNC_DEPTH                => 2,
			RESET_REQUEST_PRESENT     => 0,
			RESET_REQ_WAIT_TIME       => 1,
			MIN_RST_ASSERTION_TIME    => 3,
			RESET_REQ_EARLY_DSRT_TIME => 1,
			USE_RESET_REQUEST_IN0     => 0,
			USE_RESET_REQUEST_IN1     => 0,
			USE_RESET_REQUEST_IN2     => 0,
			USE_RESET_REQUEST_IN3     => 0,
			USE_RESET_REQUEST_IN4     => 0,
			USE_RESET_REQUEST_IN5     => 0,
			USE_RESET_REQUEST_IN6     => 0,
			USE_RESET_REQUEST_IN7     => 0,
			USE_RESET_REQUEST_IN8     => 0,
			USE_RESET_REQUEST_IN9     => 0,
			USE_RESET_REQUEST_IN10    => 0,
			USE_RESET_REQUEST_IN11    => 0,
			USE_RESET_REQUEST_IN12    => 0,
			USE_RESET_REQUEST_IN13    => 0,
			USE_RESET_REQUEST_IN14    => 0,
			USE_RESET_REQUEST_IN15    => 0,
			ADAPT_RESET_REQUEST       => 0
		)
		port map (
			reset_in0      => cpu_debug_reset_request_reset,      -- reset_in0.reset
			clk            => clocks_sys_clk_clk,                 --       clk.clk
			reset_out      => rst_controller_001_reset_out_reset, -- reset_out.reset
			reset_req      => open,                               -- (terminated)
			reset_req_in0  => '0',                                -- (terminated)
			reset_in1      => '0',                                -- (terminated)
			reset_req_in1  => '0',                                -- (terminated)
			reset_in2      => '0',                                -- (terminated)
			reset_req_in2  => '0',                                -- (terminated)
			reset_in3      => '0',                                -- (terminated)
			reset_req_in3  => '0',                                -- (terminated)
			reset_in4      => '0',                                -- (terminated)
			reset_req_in4  => '0',                                -- (terminated)
			reset_in5      => '0',                                -- (terminated)
			reset_req_in5  => '0',                                -- (terminated)
			reset_in6      => '0',                                -- (terminated)
			reset_req_in6  => '0',                                -- (terminated)
			reset_in7      => '0',                                -- (terminated)
			reset_req_in7  => '0',                                -- (terminated)
			reset_in8      => '0',                                -- (terminated)
			reset_req_in8  => '0',                                -- (terminated)
			reset_in9      => '0',                                -- (terminated)
			reset_req_in9  => '0',                                -- (terminated)
			reset_in10     => '0',                                -- (terminated)
			reset_req_in10 => '0',                                -- (terminated)
			reset_in11     => '0',                                -- (terminated)
			reset_req_in11 => '0',                                -- (terminated)
			reset_in12     => '0',                                -- (terminated)
			reset_req_in12 => '0',                                -- (terminated)
			reset_in13     => '0',                                -- (terminated)
			reset_req_in13 => '0',                                -- (terminated)
			reset_in14     => '0',                                -- (terminated)
			reset_req_in14 => '0',                                -- (terminated)
			reset_in15     => '0',                                -- (terminated)
			reset_req_in15 => '0'                                 -- (terminated)
		);

	rst_controller_002 : component nios_system_2a_rst_controller_001
		generic map (
			NUM_RESET_INPUTS          => 1,
			OUTPUT_RESET_SYNC_EDGES   => "deassert",
			SYNC_DEPTH                => 2,
			RESET_REQUEST_PRESENT     => 0,
			RESET_REQ_WAIT_TIME       => 1,
			MIN_RST_ASSERTION_TIME    => 3,
			RESET_REQ_EARLY_DSRT_TIME => 1,
			USE_RESET_REQUEST_IN0     => 0,
			USE_RESET_REQUEST_IN1     => 0,
			USE_RESET_REQUEST_IN2     => 0,
			USE_RESET_REQUEST_IN3     => 0,
			USE_RESET_REQUEST_IN4     => 0,
			USE_RESET_REQUEST_IN5     => 0,
			USE_RESET_REQUEST_IN6     => 0,
			USE_RESET_REQUEST_IN7     => 0,
			USE_RESET_REQUEST_IN8     => 0,
			USE_RESET_REQUEST_IN9     => 0,
			USE_RESET_REQUEST_IN10    => 0,
			USE_RESET_REQUEST_IN11    => 0,
			USE_RESET_REQUEST_IN12    => 0,
			USE_RESET_REQUEST_IN13    => 0,
			USE_RESET_REQUEST_IN14    => 0,
			USE_RESET_REQUEST_IN15    => 0,
			ADAPT_RESET_REQUEST       => 0
		)
		port map (
			reset_in0      => video_pll_0_reset_source_reset,     -- reset_in0.reset
			clk            => video_pll_0_vga_clk_clk,            --       clk.clk
			reset_out      => rst_controller_002_reset_out_reset, -- reset_out.reset
			reset_req      => open,                               -- (terminated)
			reset_req_in0  => '0',                                -- (terminated)
			reset_in1      => '0',                                -- (terminated)
			reset_req_in1  => '0',                                -- (terminated)
			reset_in2      => '0',                                -- (terminated)
			reset_req_in2  => '0',                                -- (terminated)
			reset_in3      => '0',                                -- (terminated)
			reset_req_in3  => '0',                                -- (terminated)
			reset_in4      => '0',                                -- (terminated)
			reset_req_in4  => '0',                                -- (terminated)
			reset_in5      => '0',                                -- (terminated)
			reset_req_in5  => '0',                                -- (terminated)
			reset_in6      => '0',                                -- (terminated)
			reset_req_in6  => '0',                                -- (terminated)
			reset_in7      => '0',                                -- (terminated)
			reset_req_in7  => '0',                                -- (terminated)
			reset_in8      => '0',                                -- (terminated)
			reset_req_in8  => '0',                                -- (terminated)
			reset_in9      => '0',                                -- (terminated)
			reset_req_in9  => '0',                                -- (terminated)
			reset_in10     => '0',                                -- (terminated)
			reset_req_in10 => '0',                                -- (terminated)
			reset_in11     => '0',                                -- (terminated)
			reset_req_in11 => '0',                                -- (terminated)
			reset_in12     => '0',                                -- (terminated)
			reset_req_in12 => '0',                                -- (terminated)
			reset_in13     => '0',                                -- (terminated)
			reset_req_in13 => '0',                                -- (terminated)
			reset_in14     => '0',                                -- (terminated)
			reset_req_in14 => '0',                                -- (terminated)
			reset_in15     => '0',                                -- (terminated)
			reset_req_in15 => '0'                                 -- (terminated)
		);

	rst_controller_003 : component nios_system_2a_rst_controller_003
		generic map (
			NUM_RESET_INPUTS          => 2,
			OUTPUT_RESET_SYNC_EDGES   => "deassert",
			SYNC_DEPTH                => 2,
			RESET_REQUEST_PRESENT     => 0,
			RESET_REQ_WAIT_TIME       => 1,
			MIN_RST_ASSERTION_TIME    => 3,
			RESET_REQ_EARLY_DSRT_TIME => 1,
			USE_RESET_REQUEST_IN0     => 0,
			USE_RESET_REQUEST_IN1     => 0,
			USE_RESET_REQUEST_IN2     => 0,
			USE_RESET_REQUEST_IN3     => 0,
			USE_RESET_REQUEST_IN4     => 0,
			USE_RESET_REQUEST_IN5     => 0,
			USE_RESET_REQUEST_IN6     => 0,
			USE_RESET_REQUEST_IN7     => 0,
			USE_RESET_REQUEST_IN8     => 0,
			USE_RESET_REQUEST_IN9     => 0,
			USE_RESET_REQUEST_IN10    => 0,
			USE_RESET_REQUEST_IN11    => 0,
			USE_RESET_REQUEST_IN12    => 0,
			USE_RESET_REQUEST_IN13    => 0,
			USE_RESET_REQUEST_IN14    => 0,
			USE_RESET_REQUEST_IN15    => 0,
			ADAPT_RESET_REQUEST       => 0
		)
		port map (
			reset_in0      => cpu_debug_reset_request_reset,      -- reset_in0.reset
			reset_in1      => video_pll_0_reset_source_reset,     -- reset_in1.reset
			clk            => video_pll_0_vga_clk_clk,            --       clk.clk
			reset_out      => rst_controller_003_reset_out_reset, -- reset_out.reset
			reset_req      => open,                               -- (terminated)
			reset_req_in0  => '0',                                -- (terminated)
			reset_req_in1  => '0',                                -- (terminated)
			reset_in2      => '0',                                -- (terminated)
			reset_req_in2  => '0',                                -- (terminated)
			reset_in3      => '0',                                -- (terminated)
			reset_req_in3  => '0',                                -- (terminated)
			reset_in4      => '0',                                -- (terminated)
			reset_req_in4  => '0',                                -- (terminated)
			reset_in5      => '0',                                -- (terminated)
			reset_req_in5  => '0',                                -- (terminated)
			reset_in6      => '0',                                -- (terminated)
			reset_req_in6  => '0',                                -- (terminated)
			reset_in7      => '0',                                -- (terminated)
			reset_req_in7  => '0',                                -- (terminated)
			reset_in8      => '0',                                -- (terminated)
			reset_req_in8  => '0',                                -- (terminated)
			reset_in9      => '0',                                -- (terminated)
			reset_req_in9  => '0',                                -- (terminated)
			reset_in10     => '0',                                -- (terminated)
			reset_req_in10 => '0',                                -- (terminated)
			reset_in11     => '0',                                -- (terminated)
			reset_req_in11 => '0',                                -- (terminated)
			reset_in12     => '0',                                -- (terminated)
			reset_req_in12 => '0',                                -- (terminated)
			reset_in13     => '0',                                -- (terminated)
			reset_req_in13 => '0',                                -- (terminated)
			reset_in14     => '0',                                -- (terminated)
			reset_req_in14 => '0',                                -- (terminated)
			reset_in15     => '0',                                -- (terminated)
			reset_req_in15 => '0'                                 -- (terminated)
		);

	mm_interconnect_0_jtag_uart_avalon_jtag_slave_read_ports_inv <= not mm_interconnect_0_jtag_uart_avalon_jtag_slave_read;

	mm_interconnect_0_jtag_uart_avalon_jtag_slave_write_ports_inv <= not mm_interconnect_0_jtag_uart_avalon_jtag_slave_write;

	mm_interconnect_0_led_pio_s1_write_ports_inv <= not mm_interconnect_0_led_pio_s1_write;

	mm_interconnect_0_sdram_s1_read_ports_inv <= not mm_interconnect_0_sdram_s1_read;

	mm_interconnect_0_sdram_s1_byteenable_ports_inv <= not mm_interconnect_0_sdram_s1_byteenable;

	mm_interconnect_0_sdram_s1_write_ports_inv <= not mm_interconnect_0_sdram_s1_write;

	mm_interconnect_0_high_res_timer_s1_write_ports_inv <= not mm_interconnect_0_high_res_timer_s1_write;

	mm_interconnect_0_button_pio_s1_write_ports_inv <= not mm_interconnect_0_button_pio_s1_write;

	rst_controller_reset_out_reset_ports_inv <= not rst_controller_reset_out_reset;

end architecture rtl; -- of Nios_System_2A
