TonnyChenProgramming/701/(commit log)

2026-04-16 decode phase finished
    [ISR.xlsx]
2026-04-17 fsm implemented （unverified）
    [Recop_Project.smp_dump.txt]
2026-04-18 interface for current state provided for debugging
    [Recop_Project.smp_dump.txt]
2026-04-18 rom update
    [_vhdl.psm, beh.psm, behaviour.psm, combined.psm, sim.psm, syn.psm]
2026-04-18 init/reset pc plus one bug fixed
    [_vhdl.psm, beh.psm, combined.psm, sim.psm]
2026-04-18 recop hardcoded partlally done
    [beh.psm]
2026-04-18 prefetch added
    [beh.psm]
2026-04-19 datacall fixed
    [_vhdl.psm, beh.psm, sim.psm, structural.psm]
2026-04-19 testbench succeed
    [sim.psm]
2026-04-19 pass all the current test
2026-04-21 de1 soc version
    [701_A1.smp_dump.txt, _vhdl.psm, beh.psm, behaviour.psm, c5_pin_model_dump.txt, combined.psm, sim.psm, structural.psm]
2026-04-21 pass synthesis after organisation
    [syn.psm]
2026-04-21 register arithemetic fixed
    [701_A1.smp_dump.txt, beh.psm, combined.psm, sim.psm]
2026-04-21 PLL added to fixed the clock time
    [recop_de1_soc_test.vhd]
2026-04-21 add assemble contents in report and README
    report and README update
2026-05-03 correlation datapath
    [c5_pin_model_dump.txt]
2026-05-20 current push
    [ASP.smp_dump.txt, c5_pin_model_dump.txt]
2026-05-20 Upload PD-ASP
    [_vhdl.psm, body.psm, c5_pin_model_dump.txt, rtl.psm, sim.psm]
2026-05-28 Add Member B Nios II support documentation
    Add three Member B documentation files for the GP2 project: an Avalon-NoC adapter register map, a Nios II support plan, and a test/evidence checklist. The register map defines the 32-bit packet format, register offsets, control/status bit fields, and Nios TX/RX sequences. The support plan describes responsibilities, UART command set, packet examples, and integration notes (branch: Eric_GP2). The test evidence file lists dry-run, adapter register, ReCOP integration, display, and optional instruction-upload checks to guide validation and demo readiness.
2026-05-28 Add initial Nios UART command skeleton
    Add a dry-run Nios II UART/JTAG console and packet helpers. Files added:
    - nios_support/uart/README.md: documents commands, packet format, usage and integration notes.
    - nios_support/uart/nios_packet.h: packet constants and inline helpers to build/parse 32-bit ASP packets.
    - nios_support/uart/nios_uart_console.c: simple fgets/printf command parser that builds packets (mode, window, start, reset, status, help) and prints TX packets; includes a dry-run hook to replace with Avalon-MM register writes when the Nios-to-NoC adapter is available.
    Defaults: mode=1, window=64. This commit provides a development scaffold for sending ReCOP command packets from Ni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
    [nios_packet.h, nios_uart_console.c]
2026-05-28 Add Nios-to-NoC adapter header
    Introduce nios_noc_adapter.h defining Avalon-MM register offsets, control/status bit masks, and a nios_noc_reg_addr() helper for computing register addresses. Update UART README to reference the new header and instruct using it when implementing nios_send_packet() to perform register writes for the Avalon-NoC adapter. This provides a clear register contract for Nios II code interacting with the NoC adapter.
2026-05-28 Add nios_command module and refactor console
    Add nios_command.h/.c implementing a reusable command API and state (mode, window, last TX/RX) plus helpers for sending/printing packets (dry-run prints). Refactor nios_uart_console.c to use the new nios_command_* functions and state, removing duplicated state and send/print helpers. Update README to document the new files and to instruct replacing the send hook in nios_command.c with Avalon-MM register writes when the Nios-to-NoC adapter is present. Also tighten u16 parsing to a 0xFFFF bound.
    [nios_command.c, nios_command.h, nios_uart_console.c]
2026-05-28 Add TDMA-MIN wrappers for ADC and AVG ASPs
    add wrapper
2026-05-29 Add offset/rx and generalize NoC config packets
    Refactor UART command handling and packet construction for NoC-directed configuration. README updated to document new packet targets, new `offset` and `rx` console commands, and revised example packet values. nios_packet.h: replace RecOP-specific helpers with generic nios_make_config / nios_make_simple_cmd that accept a destination. nios_command.c / .h: add offset state/handler, update set_mode/set_window to send configs to ASP addresses (AVE/COR/ADC) instead of RecOP, and include offset in status output. nios_uart_console.c: add parsing and handlers for offset and rx mocking, update help text. nios_noc_adapter.h: rename RX source macro to NIOS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
    [nios_command.c, nios_command.h, nios_noc_adapter.h, nios_packet.h, nios_uart_console.c]
2026-05-29 Revise GP2 Member B test evidence and packet formats
    Update GP2 Member B test evidence to clarify packet formats and integration paths. Changed expected TX packet hex values and added new commands (offset, rx decode) and a window command that emits two packets. Clarified register-level test step to indicate config packet semantics for ADC/source. Renamed the ReCOP command section to ASP Config Path, updated expected behaviors/evidence to reference NoC/ASP decoders, and added a separate ReCOP Board-Control Evidence section for board-driven control (switch/button -> ReCOP -> ASPs). Also updated checklist entries to expect ASP receipt of Nios config packets.
2026-05-29 Refactor Nios UART commands to ADC/AVG/COR/PK
    Introduce a clearer NoC command interface and update Nios UART tooling to use explicit ADC/AVG/COR/PK commands instead of the previous host "mode" tag. Changes include:
    - Add ASP_NoC_Command_Interface.md documenting packet format, shared addresses/tags, and example command words.
    - Update documentation (register map, Member B plan, test evidence, README) to use new commands (adc, avg, corwin, pk) and updated example packet words.
    - Refactor Nios command code: replace mode/window/offset fields with explicit state for adc/avg/cor/pk, add nios_command_config_* APIs (adc, avg, cor_window, cor_offset, pk), and remove the host mode tag constants.
    - Up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
    [nios_command.c, nios_command.h, nios_packet.h, nios_uart_console.c]
2026-05-29 rm files
    [ASP.smp_dump.txt, c5_pin_model_dump.txt]
2026-05-30 Add Avalon-NoC adapter support and polling
    Introduce a simple Avalon-NoC adapter backend and integrate it into the Nios UART command console. Adds nios_noc_adapter.h/.c (nios_noc_adapter_t, init, tx/rx status, send, try_recv, clear, and a default timeout) and wire it into nios_command: state.adapter, attach/detach, nios_command_send now routes through the adapter, plus nios_command_poll_adapter to poll/print received packets. nios_command_print_status now shows link mode and adapter TX/RX status. nios_uart_console conditionally initializes and attaches the adapter when NIOS_NOC_ADAPTER_BASE is defined and exposes the new poll command. Documentation and test evidence updated to reference NIOS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
2026-05-30 Pretty-print Nios packets and add event tags
    Add human-readable decoding and event support for Nios UART packets. nios_command.c: introduce helper name functions and enhance nios_command_print_rx to display kind/dest/code, show command/tag/value, data code, status codes, and EVENT peak_count. nios_packet.h: add event and data tag constants, introduce a 20-bit payload mask constant and nios_packet_payload() accessor, and use the mask in nios_make_packet. Update documentation (ASP_NoC_Command_Interface.md, GP2_Member_B_Test_Evidence.md, README) to reflect shared tags/event codes and the new RX mock output format (PK MAX_PEAK example). These changes improve RX packet readability and add explici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
2026-05-30 Add status rules & Nios status parsing
    Document MVPstatus/LED rules across ASP_NoC_Command_Interface, GP2_Member_B_Nios_Support_Plan, and Test_Evidence (including example STATUS RX in UART README). Add packet support and parsing in the Nios UART code: nios_packet.h defines status bitfields and accessors, and nios_command.c adds nios_status_name() and prints detailed STATUS fields (source, running/done/error/detail). This enables owner-based status routing (CONFIG_DONE to Nios, START/STOP/CLEAR_DONE to ReCOP, PK events to Nios) and human-readable UART output for status packets.
    [nios_command.c, nios_packet.h]
2026-05-31 Cache Nios peak/config status and print
    Add a small command-state snapshot for UART/VGA: latest_peak_count, config_done_mask, and last status (source/code/detail) with presence flags. nios_command_record_rx now updates the peak count, accumulates a config-done mask for successful CONFIG acknowledgements, and records the last STATUS packet; nios_command_print_status prints cfg/peak/ack fields. Header prototypes for nios_dest_name/nios_status_name were added. Documentation and README updated to describe the snapshot, expected test output, and guidance for a future VGA layer to consume the cached snapshot rather than re-decoding packets.
2026-05-31 Add nios_display UART/VGA snapshot support
    Introduce a lightweight nios_display module to format and print a compact Nios ASP status snapshot via UART and optionally an Avalon character-buffer VGA. Adds nios_display.c/.h, wires a new "display" console command (nios_uart_console.c) to print the snapshot and refresh VGA, and updates README and test/support docs to describe usage and expected output. VGA writes are conditional on defining NIOS_VGA_CHAR_BUFFER_BASE; the module intentionally avoids pulling in the larger FreeRTOS graph task from the older VGA code.
    [nios_display.c, nios_display.h, nios_uart_console.c]
2026-05-31 Add Avalon-NoC adapter RTL, testbench, and docs
    Add a minimal Avalon-MM to TDMA-MIN bridge (nios_support/adapter/avalon_noc_adapter.vhd) with a one-entry TX/RX holding register, a focused simulation (nios_support/adapter/avalon_noc_adapter_tb.vhd), and a README for build/run instructions. Introduce shared TDMA-MIN port types in common/TdmaMinTypes.vhd and update documentation (GP2_Avalon_NoC_Adapter_Register_Map.md, GP2_Member_B_Test_Evidence.md) to reference the new RTL and testbench. Notes: the Avalon slave uses a 3-bit word address (maps words 0..7 to byte offsets 0x00..0x1C) and TdmaMinTypes.vhd must be compiled after common/asp_packet_pkg.vhd. The testbench verifies reset/ready, TX rout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
    [TdmaMinTypes.vhd, avalon_noc_adapter.vhd, avalon_noc_adapter_tb.vhd]
2026-05-31 Add adapter loopback/status and UART commands
    Expose adapter status bits and add loopback support for board smoke tests. Documentation updated (register map, test evidence, adapter README, UART README) to describe new Adapter Status bits and a recommended hwloop smoke-test flow. Testbench (avalon_noc_adapter_tb.vhd) exercises adapter control/status and loopback path. Nios code: new APIs to read adapter status, clear adapter state, and set loopback (nios_noc_adapter.c/.h); console help and handlers added for hwstatus, hwclear, and hwloop (nios_uart_console.c, nios_command.c/.h). These changes let developers verify Avalon-MM TX/RX/ack wiring and adapter behavior before TDMA-MIN integration.
2026-06-01 Add Quartus/Nios support files; adjust Tcl ports
    Add DE1-SoC Quartus project files and Nios support (QSF, QPF, QSYS, VHDL, pin model, and adapter bitmap), plus nios_adapter_test files. Add .gitignore entries to ignore Quartus build/artifacts and generated Platform Designer output. Modify avalon_noc_adapter_pd_hw.tcl: remove ANALYZE_HDL property and rename noc_send/noc_recv interface ports to use explicit signal names (addr/data) and update direction declarations.
    [c5_pin_model_dump.txt]
2026-06-02 Add Nios II adapter console software and BSP
    Introduce the nios_adapter_console Quartus/Nios II software project and its BSP. Adds Eclipse project files, source headers/sources for the adapter (nios_command, nios_display, nios_noc_adapter, nios_uart_console, packet types), prebuilt artifacts (ELF, map, objdump), and the full BSP HAL, drivers and build outputs. Also update .gitignore to exclude local/generated software/ workspace artifacts.
2026-06-02 Add VGA character buffer and map adapter/VGA addresses
    Add an optional text-only VGA character buffer to the Platform Designer system and expose it to software and the top-level FPGA design. Updates include:
    - nios_support/quartus/Nios_System_2A.qsys: add video_character_buffer_with_dma, dual-clock buffer, PLL and VGA controller modules; add address map entries (char buffer at 0x08012000, control at 0x08011070); add streaming, clock and reset connections.
    - nios_support/quartus/nios_adapter_test.vhd: expose VGA pins on the top-level entity and wire them to the generated Qsys conduits.
    - nios_support/quartus/software/nios_adapter_console/Makefile: define NIOS_VGA_CHAR_BUFFER_BASE and keep ex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
    [nios_adapter_test.vhd]
2026-06-02 Add VGA character buffer DMA driver to BSP
    Add Altera VGA character buffer with DMA driver and integrate it into the Nios BSP and console build. New driver headers and source (altera_up_avalon_video_character_buffer_with_dma.*) and compiled objects were added, alt_sys_init updated to call alt_up_char_buffer_init/alt_find_dev, and BSP Makefile/settings/system.h/summary updated. Resulting binaries and artifacts (libhal_bsp.a, .elf, .map, .objdump, and obj files like nios_display.o) were rebuilt to include the driver so the console can use the VGA character buffer DMA.
2026-06-02 Add automatic ReCOP STATUS responses
    Emit an automatic PKT_KIND_STATUS packet to ReCOP whenever control commands (CONFIG/START/STOP/CLEAR/NOP) are received, matching other ASPs' board-control feedback. Updates in pd_asp.vhd: add status_pending_r and status_command_r signals, initialize them on reset, handle CMD_CLEAR, build a status_control_payload (bit 15 = enabled, bit 14 = config applied, bit 13 = clear applied, bits 3..0 = acknowledged command), and send the STATUS packet to RECOP_PORT when pending. Testbench pd_asp_tb.vhd: add observed_control_status, send STOP and CLEAR in the sequence, and verify four automatic control STATUS replies are observed and routed to ReCOP with expected payl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
    [pd_asp.vhd, pd_asp_tb.vhd]
2026-06-02 modify the recop to support all the status repsonese& led update
2026-06-02 interfaced added， modify recop to 80MHZ
    [701_A1.smp_dump.txt]
2026-06-06 add member c solomon work and update relevant codes from Tony and Eric for integration purpose
    Integrate GP2 ASP NoC board demo with Nios and ReCOP control
2026-06-09 Add dashboard display and demo/capture tracking
    Track demo and capture state and expand VGA dashboard. Adds new fields to nios_command_state_t (last_demo_name/count, last_capture_requested/received/overflow, peak_event_packets, board_demo_armed) and a nios_command_note_demo() helper to initialize demo state. Update nios_command_send() to mark configs in config_done_mask for small dest IDs; record peak event packet counts in record_rx(); set last_capture_overflow when poll detects RX overflow; clear overflow on HW clear; set capture summary values after capture.
    Revamp nios_display: increase display lines to 24, introduce formatting helpers (mode/path/control names and cfg mark), implement n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
